TheKingOfChaos/Console-Server/3d/preview.png

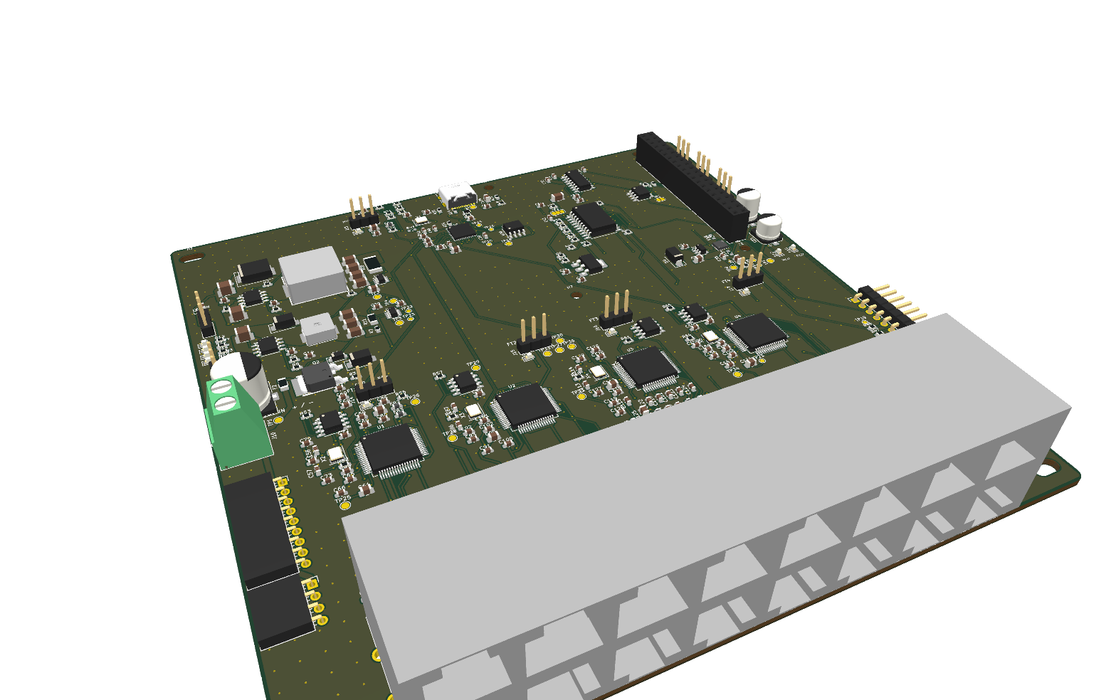
3d/preview.png
