TheKingOfChaos/Console-Server/bom/usb-console-server_bom.csv

Designator | Value | Footprint | LCSC | Spec | MPN | Note | Qty | DNP
C1,C4,C7,C13,C16,C20,C21,C24,C25,C30,C31,C32,C33,C34,C35,C37,C39,C41,C44,C45,C47,C48,C49,C50,C51,C52,C54,C59,C60,C64,C65,C66,C67,C68,C69,C70,C72,C74,C76,C77,C78,C79,C80,C81,C82,C83,C84,C85,C88,C89,C91,C92,C93,C94,C95,C96,C97,C99,C101,C103,C104,C105,C106,C107,C108,C109,C110,C111,C112,C115,C116,C118,C119,C120,C121,C122,C123,C124,C126,C128,C130,C131,C132,C133,C134,C135,C136,C137,C138,C139,C142,C143,C145,C146,C147,C148,C149,C150,C151,C153,C155,C157,C158,C159,C160,C161,C162,C163,C164,C165,C166 | 100nF | Capacitor_SMD:C_0603_1608Metric | C14663 | 50V X7R |  | VCAP to ANODE, >=25 V,VCCIO pin,VCORE pin,VREGIN | 111
C2,C3,C12 | 2.2uF | Capacitor_SMD:C_1210_3225Metric | C153036 | 100V X7R |  |  | 3
C5,C14,C36 | 4.7nF | Capacitor_SMD:C_0603_1608Metric | C53987 | 50V X7R |  |  | 3
C6,C15 | 47pF | Capacitor_SMD:C_0603_1608Metric | C1671 | 50V C0G |  |  | 2
C8,C9,C10,C11,C17,C18,C19,C55 | 22uF | Capacitor_SMD:C_1206_3216Metric | C77091 | 25V X5R |  |  | 8
C22,C174 | 1uF | Capacitor_SMD:C_0805_2012Metric | C91185 | 50V X7R |  |  | 2
C23,C26,C29,C71,C98,C125,C152 | 10uF | Capacitor_SMD:C_0805_2012Metric | C15850 | 25V X5R |  | local bulk | 7
C27 | 470uF | Capacitor_SMD:CP_Elec_6.3x7.7 | C335982 | 10V electrolytic 6.3x7.7 |  |  | 1
C28 | 220uF | Capacitor_SMD:CP_Elec_6.3x5.4 | C72494 | 10V electrolytic 6.3x5.4 |  |  | 1
C38,C40,C53,C73,C75,C100,C102,C127,C129,C154,C156 | 1uF | Capacitor_SMD:C_0603_1608Metric | C29936 | 25V X7R |  |  | 11
C42,C43,C61,C90,C117,C144 | 4.7uF | Capacitor_SMD:C_0805_2012Metric | C1779 | 25V X5R |  | VREGOUT: LDO compensation, min 3.3 uF | 6
C46 | 100uF | Capacitor_SMD:CP_Elec_10x10.5 | C51953411 | 63V electrolytic 10x10.5 |  |  | 1
C57,C58,C86,C87,C113,C114,C140,C141 | 33pF | Capacitor_SMD:C_0603_1608Metric | C1663 | 50V C0G |  | C0G | 8
C62,C63 | 15pF | Capacitor_SMD:C_0603_1608Metric | C1644 | 50V C0G |  | C0G, matched to 12 pF CL | 2
D1 | B560C | Diode_SMD:D_SMC | C85100 |  |  |  | 1
D2 | B360A | Diode_SMD:D_SMA | C94193 |  |  |  | 1
D3 | SMAJ26A | Diode_SMD:D_SMA | C148225 |  |  | 26 V standoff, 42.1 V max clamp | 1
D4 | BZT52C15 | Diode_SMD:D_SOD-123 | C668893 |  |  | 15 V gate clamp, cathode to source | 1
D5,D6,D7,D8,D10,D11,D12,D13,D14,D15,D16 | green | LED_SMD:LED_0603_1608Metric | C965805 |  |  | +24V present,+3.3V present,+3V3_MCU present,+5V present,Pi 5 V present,cluster powered,heartbeat = healthy; solid or dark = hung,hub section powered | 11
D9 | SMAJ6.0A | Diode_SMD:D_SMA | C223993 |  |  |  | 1
F2 | 0468002.NRHF | Fuse:Fuse_1206_3216Metric | C187611 |  |  | 2 A time-lag 63 V DC, I2t 0.506 A2s | 1
FB1,FB2,FB3,FB4,FB5,FB6,FB7,FB8,FB9 | BLM18KG601SN1D | Inductor_SMD:L_0603_1608Metric | C85833 |  |  |  | 9
J1 | USB-C | Connector_USB:USB_C_Receptacle_HRO_TYPE-C-31-M-12 | C165948 |  |  |  | 1
J2 | RPi GPIO 2x20 | Connector_PinSocket_2.54mm:PinSocket_2x20_P2.54mm_Vertical | C2977589 |  |  |  | 1
J3 | PWR_CHAIN | Connector_PinHeader_2.54mm:PinHeader_1x04_P2.54mm_Horizontal | C492412 |  |  | 1x04 R/A pin header | 1
J4 | PWR_CHAIN | Connector_PinSocket_2.54mm:PinSocket_1x04_P2.54mm_Horizontal | C2897386 |  |  | 1x04 R/A socket | 1
J5 | HC-RJ45-059D-2x8-2-04 | console_server:RJ45_HC-RJ45-059D-2x8 | C46261623 |  |  |  | 1
J6 | PI_CONSOLE | Connector_PinHeader_2.54mm:PinHeader_1x03_P2.54mm_Vertical | C49257 |  |  |  | 1
J7 | UPDI | Connector_PinHeader_2.54mm:PinHeader_1x03_P2.54mm_Vertical | C49257 |  |  |  | 1
J8 | LINK | Connector_PinHeader_2.54mm:PinHeader_1x09_P2.54mm_Horizontal | C492417 |  |  |  | 1
J9 | LINK | Connector_PinSocket_2.54mm:PinSocket_1x09_P2.54mm_Horizontal | C2897391 |  |  |  | 1
J10 | 24V IN | TerminalBlock_Phoenix:TerminalBlock_Phoenix_MKDS-1,5-2-5.08_1x02_P5.08mm_Horizontal | C8465 |  |  | 5.08 mm screw terminal, 18 A; same node as the chain connectors | 1
J11 | BUCK5_IN | Connector_PinHeader_2.54mm:PinHeader_1x03_P2.54mm_Vertical | C49257 |  |  | bring-up jumper, 1.2 A max | 1
J12 | BUCK3_IN | Connector_PinHeader_2.54mm:PinHeader_1x03_P2.54mm_Vertical | C49257 |  |  | bring-up jumper, 1.2 A max | 1
J13 | HUB_3V3 | Connector_PinHeader_2.54mm:PinHeader_1x03_P2.54mm_Vertical | C49257 |  |  | bring-up jumper | 1
J14,J15,J16,J17 | FT_3V3 | Connector_PinHeader_2.54mm:PinHeader_1x03_P2.54mm_Vertical | C49257 |  |  | bring-up jumper | 4
J19 | MCU_UART | Connector_PinHeader_2.54mm:PinHeader_1x03_P2.54mm_Vertical | C49257 |  |  |  | 1
L1 | 10uH | console_server:L_Bourns_SRP1265A | C305223 |  | TMPC1265HP-100MG-D | Isat 15.5 A, Irms 10 A (SRP1265A-100M equivalent) | 1
L2 | 10uH | Inductor_SMD:L_Bourns_SRP7028A_7.3x6.6mm | C2687402 |  | SRP7028A-100M | Isat 6 A, Irms 3.5 A | 1
Q1 | AON7524 | console_server:DFN-8_L3.0-W3.0-P0.65-BL-2 | C431195 |  |  |  | 1
Q2 | IRFR5305TRPBF | console_server:TO-252-3_L6.5-W6.1-P4.58-LS9.9-BR | C2624 |  |  | P-ch 55 V 65 mOhm; drain to input | 1
R1,R5 | 243k | Resistor_SMD:R_0603_1608Metric | C403098 | 1% 0603 |  |  | 2
R2,R6 | 16.9k | Resistor_SMD:R_0603_1608Metric | C2933158 | 1% 0603 |  |  | 2
R3 | 53.6k | Resistor_SMD:R_0603_1608Metric | C2930115 | 1% 0603 |  |  | 1
R4,R8,R22,R28,R29,R30,R31,R32,R33,R34,R41,R44,R46,R48,R54,R58,R62,R66 | 10k | Resistor_SMD:R_0603_1608Metric | C25804 | 1% 0603 |  | SCL pull-up AND CFG_SEL0 strap,one pull-up for all four FT4232H | 18
R7 | 31.6k | Resistor_SMD:R_0603_1608Metric | C25967 | 1% 0603 |  |  | 1
R9 | 240 | Resistor_SMD:R_0603_1608Metric | C114613 | 1% 0603 |  | 1.25V/240R = 5.2 mA min load; do not raise | 1
R10 | 5m | Resistor_SMD:R_2512_6332Metric | C393074 | 5 mOhm 1% 3W 2512 shunt |  | +5V shunt | 1
R11 | 10m | Resistor_SMD:R_1206_3216Metric | C188070 | 10 mOhm 1% 1W 1206 shunt |  | +3.3V shunt | 1
R12 | 22k | Resistor_SMD:R_0603_1608Metric | C31850 | 1% 0603 |  |  | 1
R13,R19,R53,R57,R61,R65 | 2.2k | Resistor_SMD:R_0603_1608Metric | C4190 | 1% 0603 |  |  | 6
R14,R15,R36,R55,R59,R63,R67 | 470 | Resistor_SMD:R_0603_1608Metric | C23179 | 1% 0603 |  |  | 7
R16 | 390 | Resistor_SMD:R_0603_1608Metric | C23151 | 1% 0603 |  |  | 1
R20,R21 | 3.9k | Resistor_SMD:R_0603_1608Metric | C23018 | 1% 0603 |  |  | 2
R23,R24 | 5.1k | Resistor_SMD:R_0603_1608Metric | C23186 | 1% 0603 |  |  | 2
R25,R37 | 47k | Resistor_SMD:R_0603_1608Metric | C111134 | 1% 0603 |  |  | 2
R26,R47 | 100k | Resistor_SMD:R_0603_1608Metric | C25803 | 1% 0603 |  |  | 2
R27 | 1M | Resistor_SMD:R_0603_1608Metric | C22935 | 1% 0603 |  |  | 1
R35,R52,R56,R60,R64 | 12k | Resistor_SMD:R_0603_1608Metric | C22790 | 1% |  |  | 5
R38 | 4.3k | Resistor_SMD:R_0603_1608Metric | C23159 | 1% 0603 |  |  | 1
R39,R40 | 4.7k | Resistor_SMD:R_0603_1608Metric | C23162 | 1% 0603 |  |  | 2
R42,R45,R50 | 0 | Resistor_SMD:R_0603_1608Metric | C21189 | jumper |  | ID strap: fit on boards 1, 2,ID strap: fit on boards 1, 3 | 3
R49 | 1k | Resistor_SMD:R_0603_1608Metric | C22548 | 1% 0603 |  |  | 1
U1,U2,U3,U4 | FT4232HL | Package_QFP:LQFP-64_10x10mm_P0.5mm | C56742 |  |  |  | 4
U5 | USB2514BI-AEZG-TR | Package_DFN_QFN:QFN-36-1EP_6x6mm_P0.5mm_EP3.7x3.7mm | C58940 |  |  |  | 1
U6 | ATtiny3216-SF | Package_SO:SOIC-20W_7.5x12.8mm_P1.27mm | C1340355 |  |  |  | 1
U7 | LM317 | Package_TO_SOT_SMD:SOT-223-3_TabPin2 | C5296732 |  |  |  | 1
U8 | TPS54560BDDAR | Package_SO:Texas_HSOP-8-1EP_3.9x4.9mm_P1.27mm_ThermalVias | C1850354 |  |  |  | 1
U9 | TPS54360BDDAR | Package_SO:TI_SO-PowerPAD-8_ThermalVias | C524806 |  |  |  | 1
U10,U11,U12,U13,U14,U15,U16,U17 | MAX3232EIDR | Package_SO:SOIC-16_3.9x9.9mm_P1.27mm | C193666 |  |  |  | 8
U18 | SP3232EEN-L/TR | Package_SO:SOIC-16_3.9x9.9mm_P1.27mm | C9378 |  |  |  | 1
U19 | LM74700QDBVRQ1 | Package_TO_SOT_SMD:SOT-23-6 | C2941042 |  |  |  | 1
U20 | 24LC02B-I/SN | Package_SO:SOIC-8_3.9x4.9mm_P1.27mm | C1348870 |  |  |  | 1
U21 | 24LC32A-I/SN | Package_SO:SOIC-8_3.9x4.9mm_P1.27mm | C511262 |  |  |  | 1
U22 | PRTR5V0U2F | console_server:SOT886_L1.5-W1.0-P0.50-LS1.00-BL | C478118 |  |  |  | 1
U23,U24 | INA219AIDCNR | Package_TO_SOT_SMD:SOT-23-8 | C87469 |  |  |  | 2
U31,U32,U33,U34 | 93LC46BT-I/SN | Package_SO:SOIC-8_3.9x4.9mm_P1.27mm | C16253 |  |  |  | 4
X1 | 24MHz | Crystal:Crystal_SMD_3225-4Pin_3.2x2.5mm | C5444545 |  |  | XL2EL89COI-111YLC-24M, CL 12 pF | 1
X2,X3,X4,X5 | 12MHz | Crystal:Crystal_SMD_3225-4Pin_3.2x2.5mm | C9002 |  |  | X322512MSB4SI, CL 20 pF | 4
