TheKingOfChaos/Console-Server/jlcpcb/usb-console-server_full_loose_parts.csv

LCSC Part Number | Qty per board | Value | Footprint | Designators
C100114 | 7 | 2.54 mm jumper cap | - | one per bring-up header J11-J17
