TheKingOfChaos/Console-Server/jlcpcb/usb-console-server_lcsc_order_3boards_through_hole_only.csv

LCSC Part Number | Quantity | Manufacturer Part | Value | Package | Designators
C49257 | 30 |  | PI_CONSOLE | PinHeader_1x03_P2.54mm_Vertical | J6,J7,J11,J12,J13,J14,J15,J16,J17,J19
C100114 | 21 |  | 2.54 mm jumper cap | - | one per bring-up header J11-J17
C492412 | 3 |  | PWR_CHAIN | PinHeader_1x04_P2.54mm_Horizontal | J3
C2897386 | 3 |  | PWR_CHAIN | PinSocket_1x04_P2.54mm_Horizontal | J4
C46261623 | 3 |  | HC-RJ45-059D-2x8-2-04 | RJ45_HC-RJ45-059D-2x8 | J5
C492417 | 3 |  | LINK | PinHeader_1x09_P2.54mm_Horizontal | J8
C2897391 | 3 |  | LINK | PinSocket_1x09_P2.54mm_Horizontal | J9
C8465 | 3 |  | 24V IN | TerminalBlock_Phoenix_MKDS-1,5-2-5.08_1x02_P5.08mm_Horizontal | J10
C2977589 | 1 |  | RPi GPIO 2x20 | PinSocket_2x20_P2.54mm_Vertical | J2
