TheKingOfChaos/Console-Server/3d/usb-console-server.step

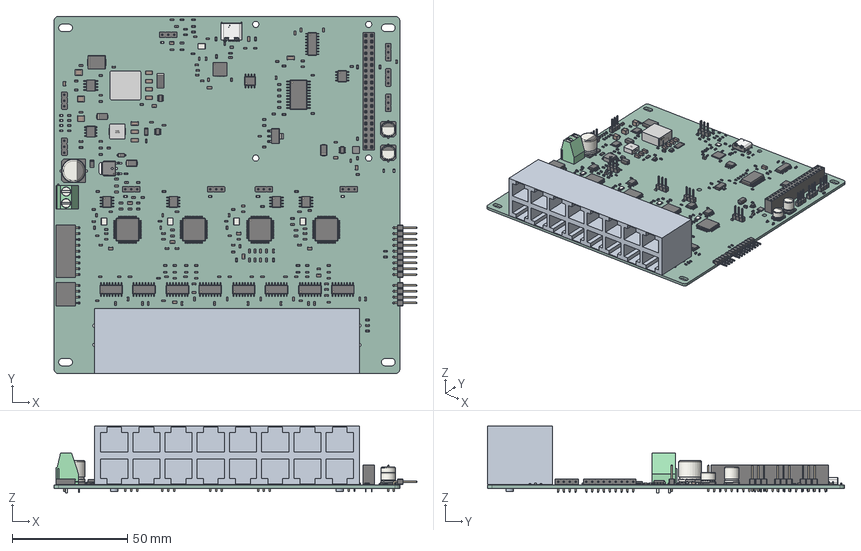
[picture p2: CAD file, 2026-10-31]
3d/usb-console-server.step
157.4 x 155.0 x 28.9 mm
LED_0603_1608Metric x 11
Crystal_SMD_3225-4Pin_3.2x2.5mm x 5
R_0603_1608Metric x 65
PinHeader_1x03_P254mm_Vertical x 10
C_0603_1608Metric x 138
C_0805_2012Metric x 15
L_0603_1608Metric x 9
PinHeader_1x09_P254mm_Horizontal
SOT-223
C_1206_3216Metric x 8
CP_Elec_63x54
SOIC-16_3.9x9.9mm_P1.27mm x 9
USB-C_SMD-TYPE-C-31-M-12
Fuse_1206_3216Metric
PinSocket_2x20_P2.54mm_Vertical
PinSocket_1x09_P2.54mm_Horizontal
SOIC-8_3.9x4.9mm_P1.27mm x 6
PinHeader_1x04_P254mm_Horizontal
D_SMA x 3
HSOP-8-1EP_3.9x4.9mm_P1.27mm_EP2.41x3.1mm
D_SOD-123
R_1206_3216Metric
SOT-23-8 x 2
QFN-36-1EP_6x6mm_Pitch0.5mm
C_1210_3225Metric x 3
TI_SO-PowerPAD-8
IND-SMD_L13.5-W12.5
LQFP-64_10x10mm_P0.5mm x 4
PinSocket_1x04_P2.54mm_Horizontal
R_2512_6332Metric
D_SMC
SOT-23-6
IND-SMD_L7.1-W6.6-H2.8
CP_Elec_10x105
CP_Elec_63x77
SOT886_L1.5-W1.0-H0.5-P0.50-LS1.00-BL
TO-252-3_L6.5-W6.1-P4.58-LS9.9-BR
TerminalBlock_Phoenix_MKDS-1,5-2-5.08_1x02_P5.08mm_Horizontal
SOIC-20W_7.5x12.8mm_P1.27mm
DFN-8_L3.0-W3.0-P0.65-BL-2
usb-console-server_PCB
