TheKingOfChaos/Console-Server/usb-console-server.kicad_pcb

## KiCad design usb-console-server.kicad_pcb (2026-11-04)

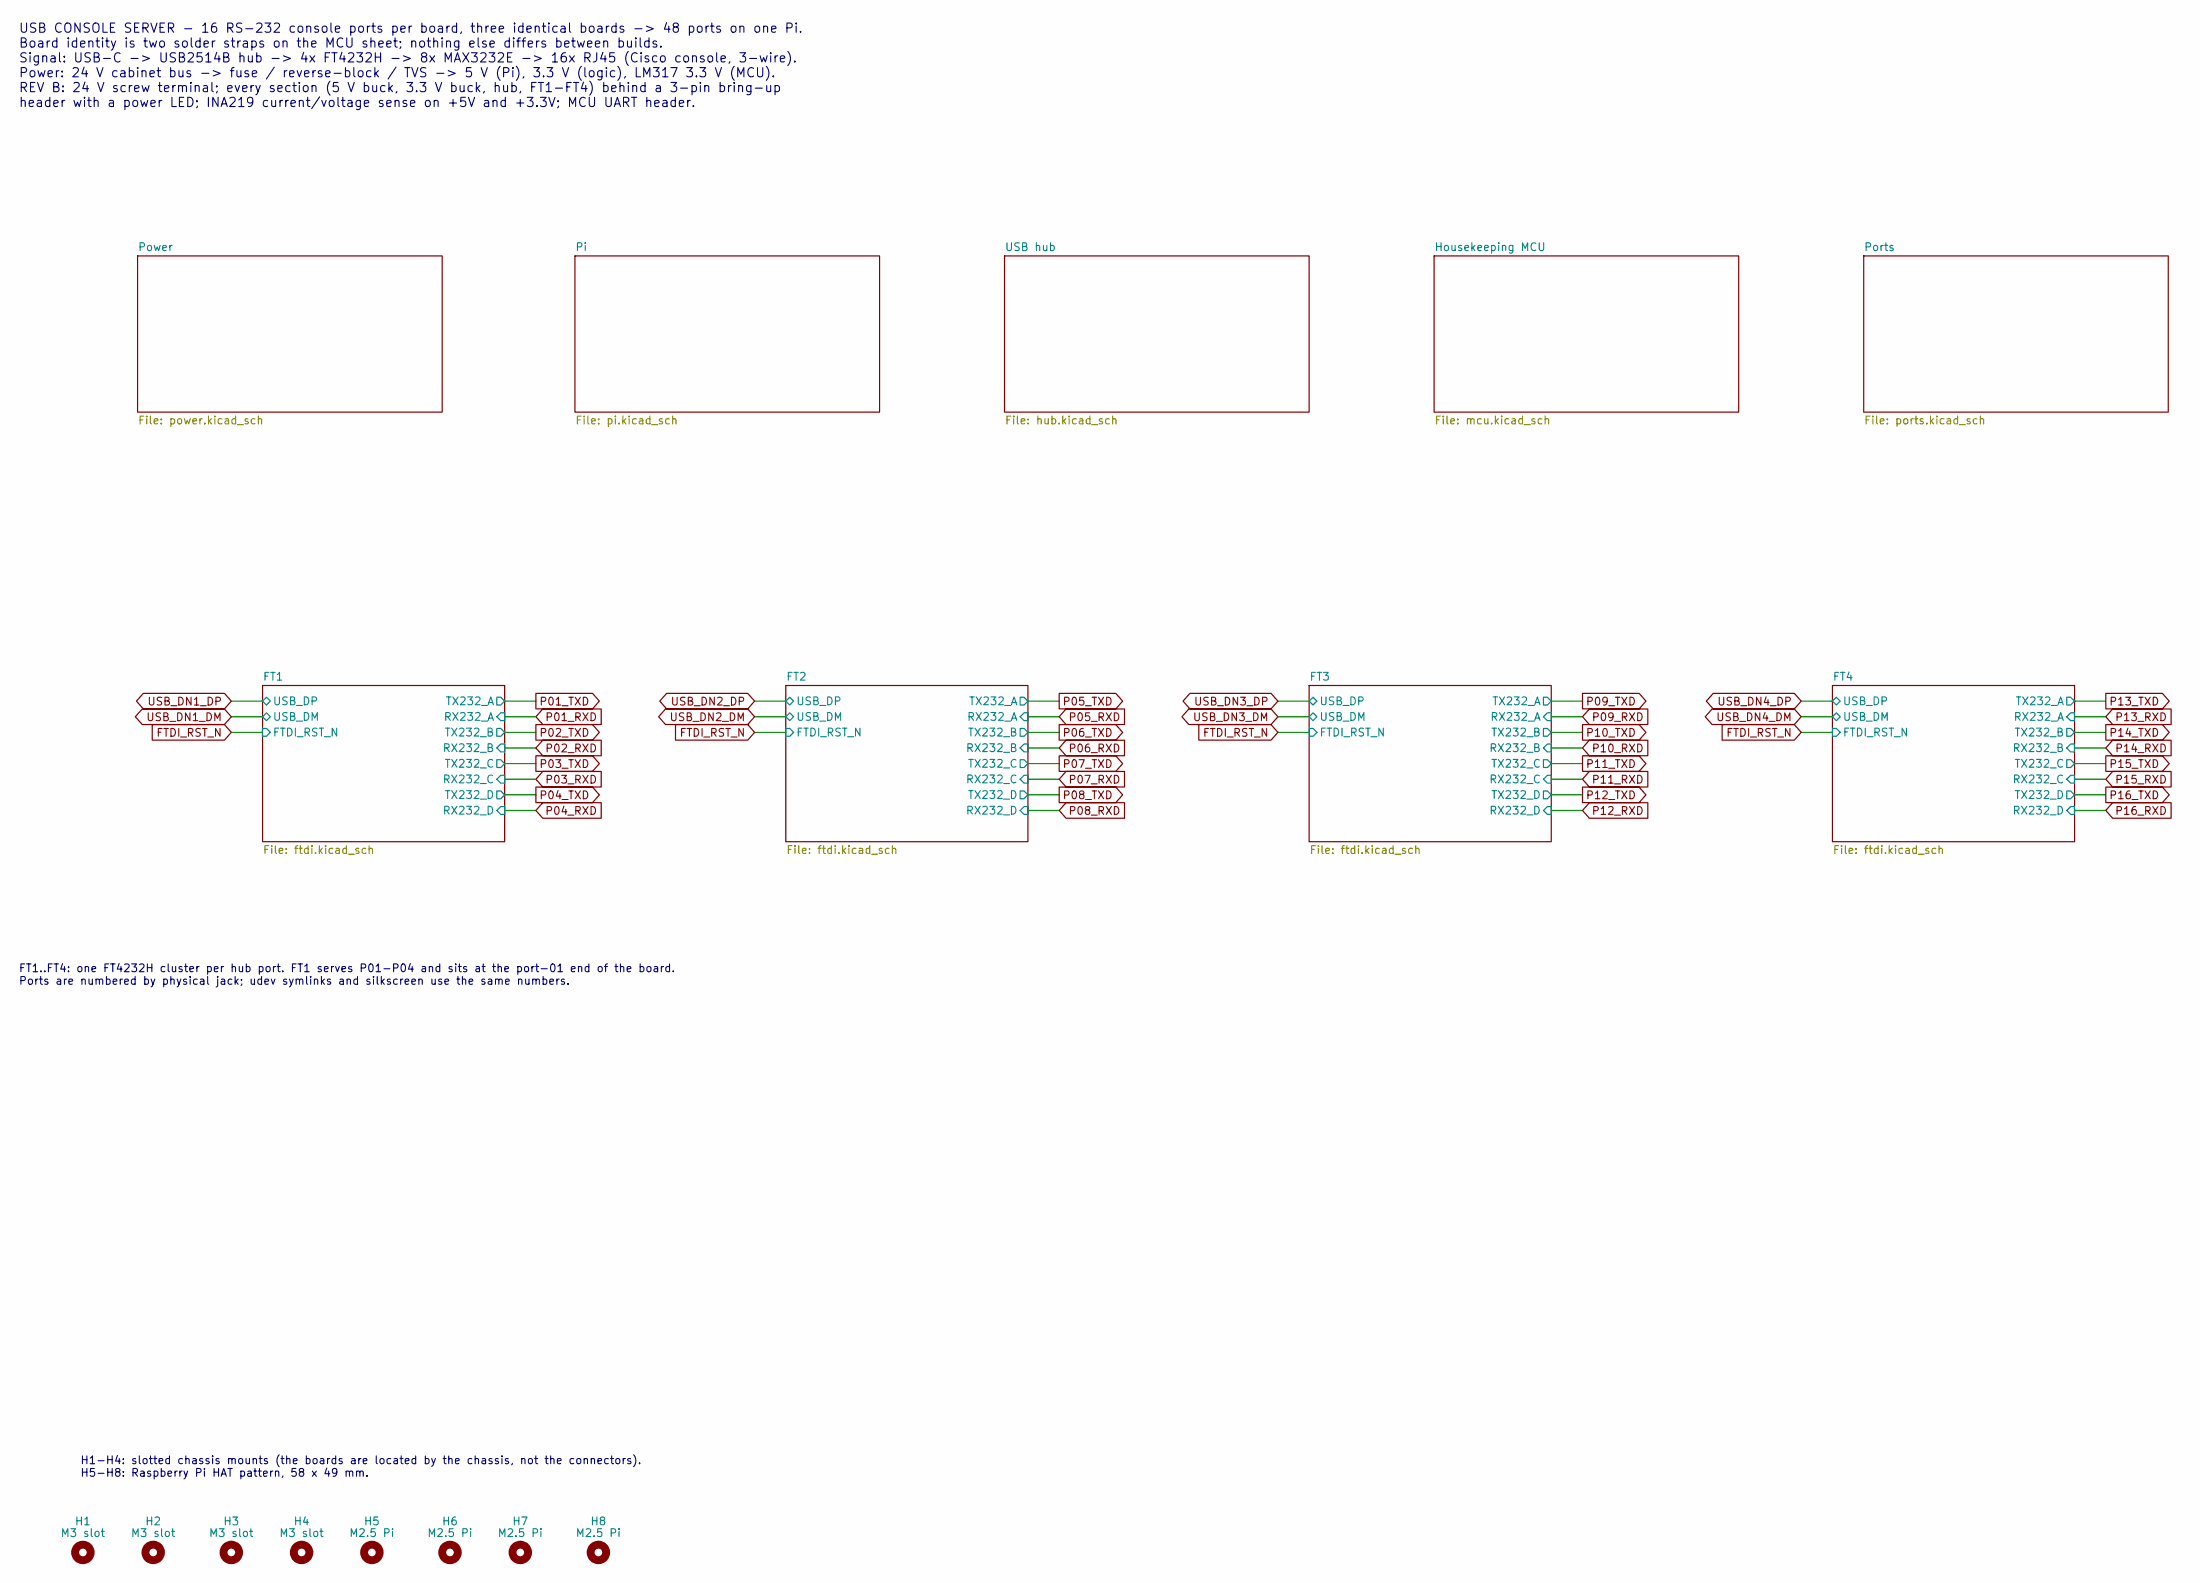
[picture p3: schematic usb-console-server.kicad_sch, USB Console Server - top level]

Parts:
H1, H2, H3, H4: M3 slot; MountingSlot_3.2x6mm
H5, H6, H7, H8: M2.5 Pi; MountingHole_2.7mm_M2.5

Notes on the sheet:
USB CONSOLE SERVER - 16 RS-232 console ports per board, three identical boards -> 48 ports on one Pi. Board identity is two solder straps on the MCU sheet; nothing else differs between builds. Signal: USB-C -> USB2514B hub -> 4x FT4232H -> 8x MAX3232E -> 16x RJ45 (Cisco console, 3-wire). Power: 24 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
FT1..FT4: one FT4232H cluster per hub port. FT1 serves P01-P04 and sits at the port-01 end of the board. Ports are numbered by physical jack; udev symlinks and silkscreen use the same numbers.
H1-H4: slotted chassis mounts (the boards are located by the chassis, not the connectors). H5-H8: Raspberry Pi HAT pattern, 58 x 49 mm.

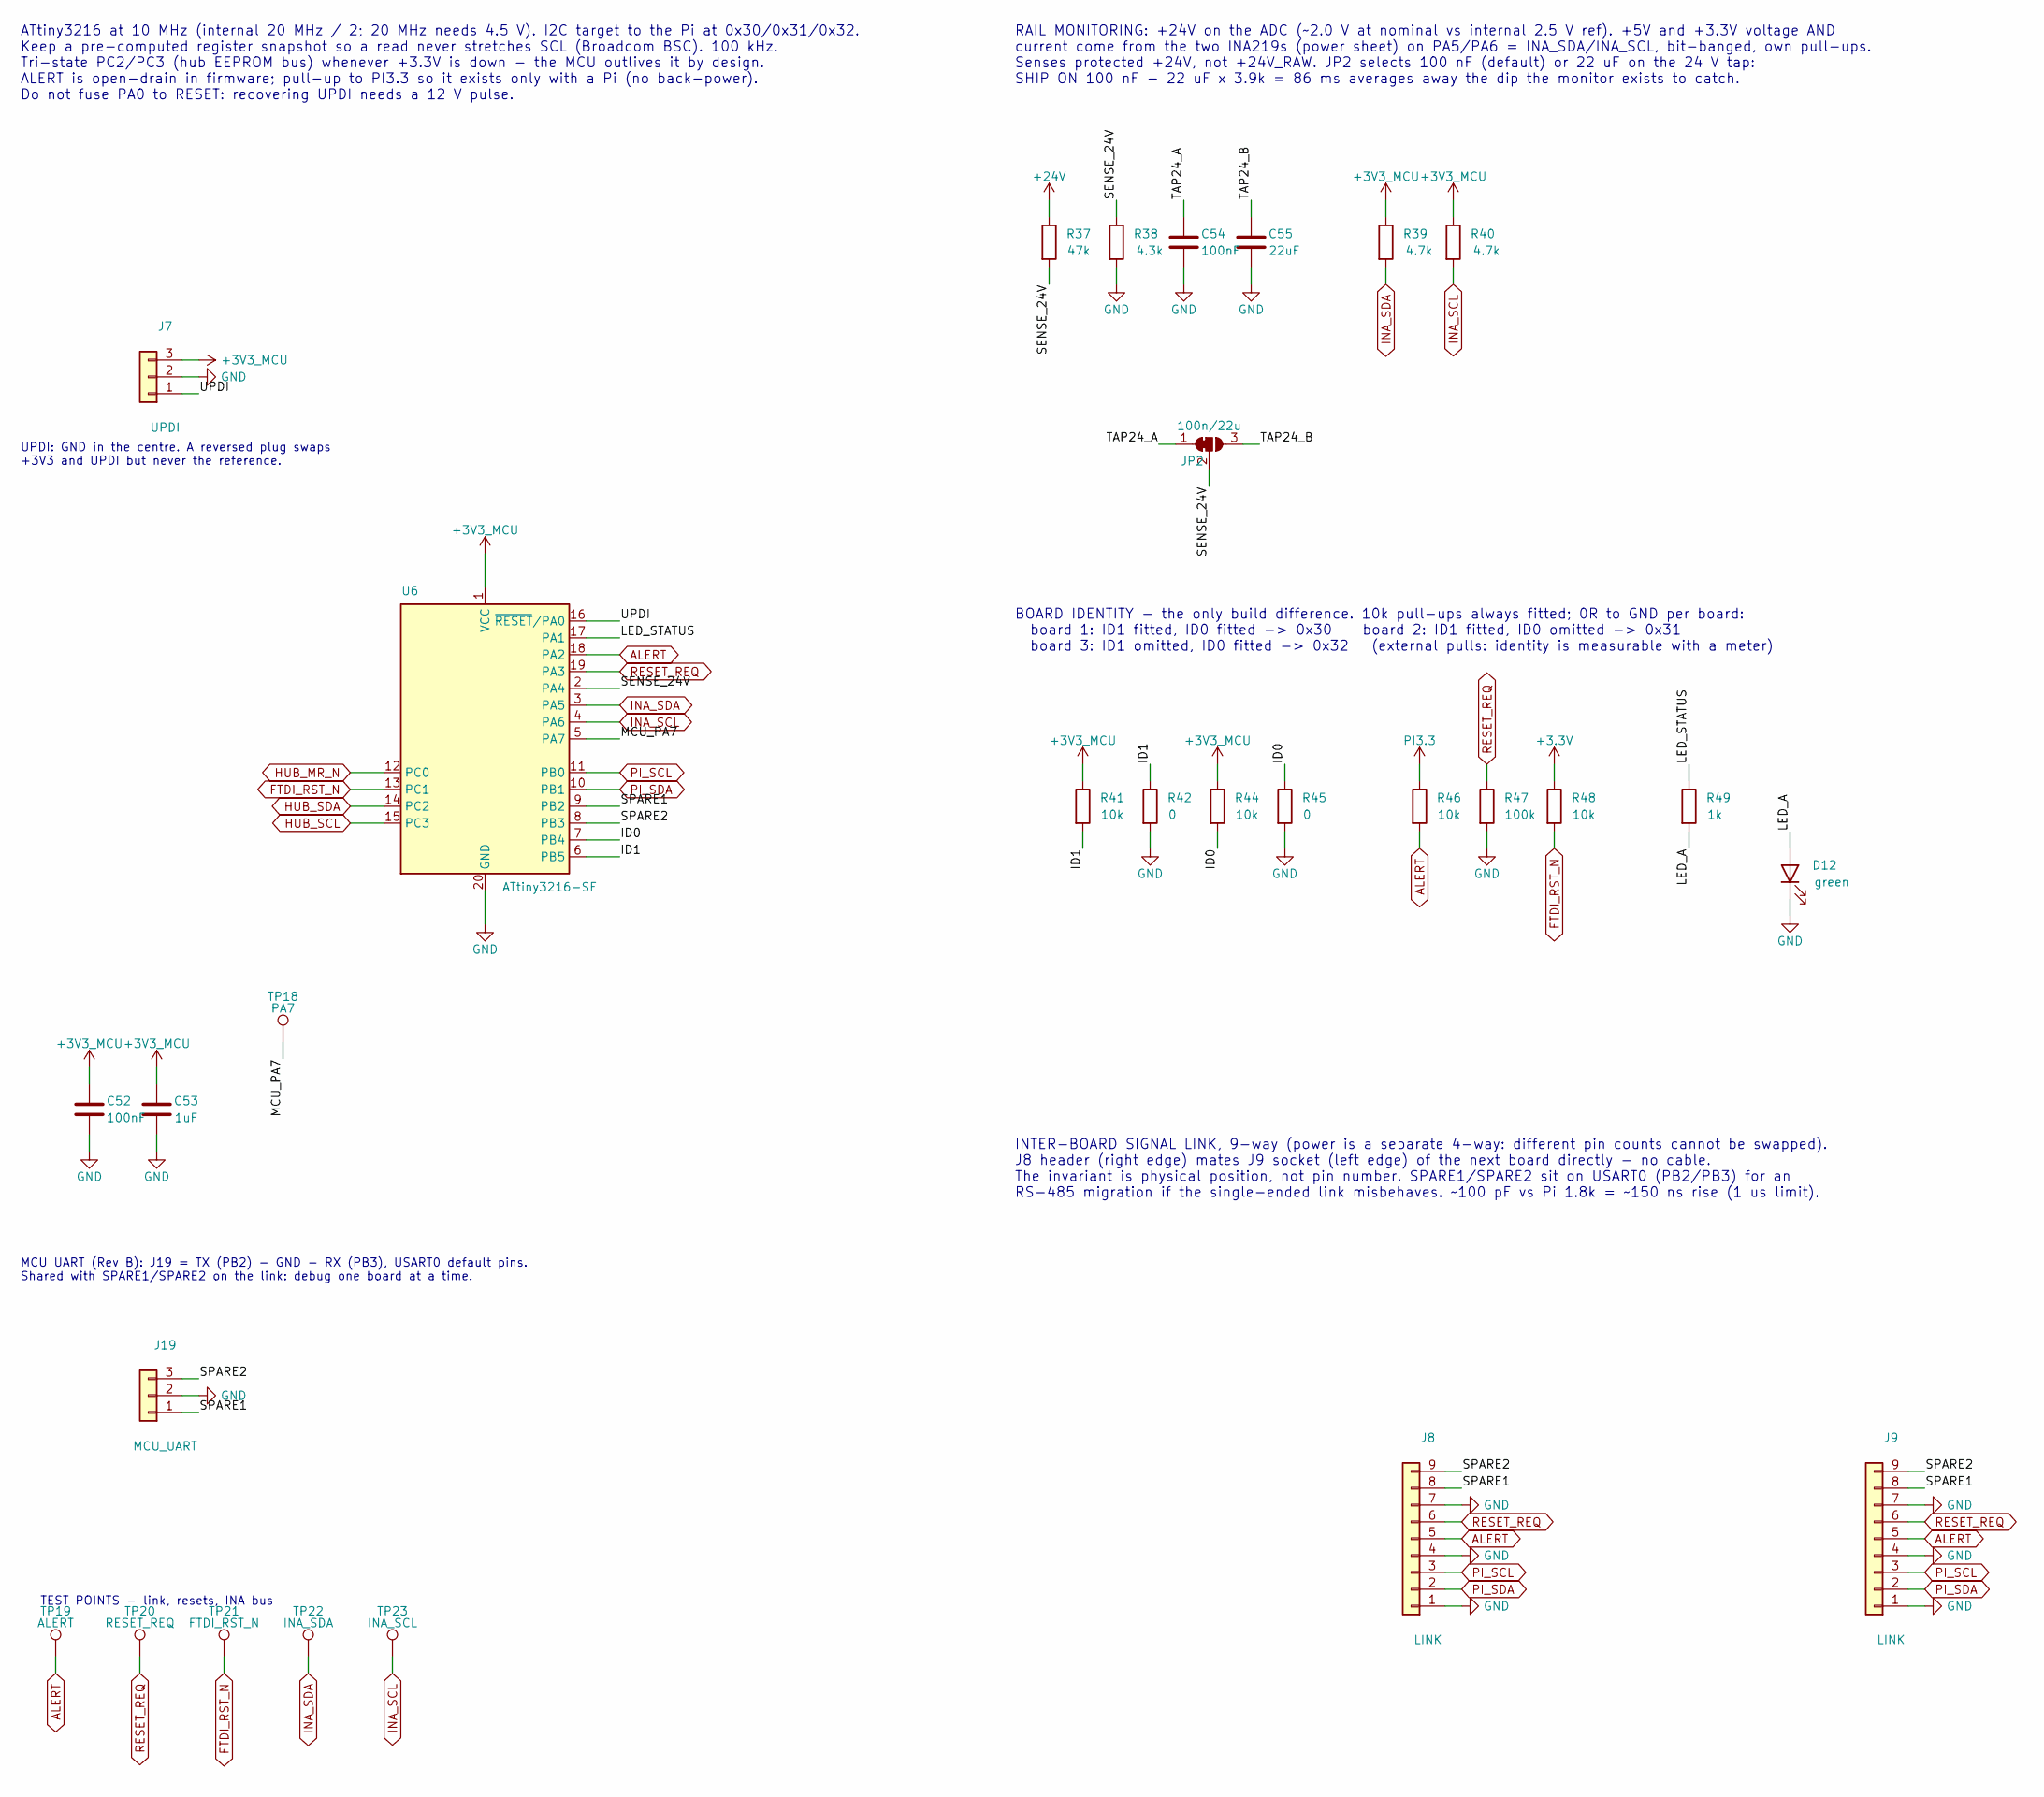
[picture p4: schematic mcu.kicad_sch, Housekeeping MCU and inter-board link]

Parts:
C52, C54: 100nF; C_0603_1608Metric; LCSC C14663
C53: 1uF; C_0603_1608Metric; LCSC C29936
C55: 22uF; C_1206_3216Metric; LCSC C77091
D12: green; LED_0603_1608Metric; LCSC C965805
J7: UPDI; PinHeader_1x03_P2.54mm_Vertical; LCSC C49257
J8: LINK; PinHeader_1x09_P2.54mm_Horizontal; LCSC C492417
J9: LINK; PinSocket_1x09_P2.54mm_Horizontal; LCSC C2897391
J19: MCU_UART; PinHeader_1x03_P2.54mm_Vertical; LCSC C49257
JP2: 100n/22u; SolderJumper-3_P1.3mm_Bridged12_RoundedPad1.0x1.5mm
R37: 47k; R_0603_1608Metric; LCSC C111134
R38: 4.3k; R_0603_1608Metric; LCSC C23159
R39, R40: 4.7k; R_0603_1608Metric; LCSC C23162
R41, R44, R46, R48: 10k; R_0603_1608Metric; LCSC C25804
R42, R45: 0; R_0603_1608Metric; LCSC C21189
R47: 100k; R_0603_1608Metric; LCSC C25803
R49: 1k; R_0603_1608Metric; LCSC C22548
TP18: PA7; TestPoint_Pad_D1.5mm
TP19: ALERT; TestPoint_Pad_D1.0mm
TP20: RESET_REQ; TestPoint_Pad_D1.0mm
TP21: FTDI_RST_N; TestPoint_Pad_D1.0mm
TP22: INA_SDA; TestPoint_Pad_D1.0mm
TP23: INA_SCL; TestPoint_Pad_D1.0mm
U6: ATtiny3216-SF; SOIC-20W_7.5x12.8mm_P1.27mm; LCSC C1340355

Connections:
+3.3V: R48.1; also elsewhere on the board
+3V3_MCU: C52.1, C53.1, J7.3, R39.1, R40.1, R41.1, R44.1, U6.1 (VCC); also elsewhere on the board
+24V: R37.1; also elsewhere on the board
/Housekeeping MCU/ID0: R44.2, R45.1, U6.7 (PB4)
/Housekeeping MCU/ID1: R41.2, R42.1, U6.6 (PB5)
/Housekeeping MCU/LED_A: D12.2 (A), R49.2
/Housekeeping MCU/LED_STATUS: R49.1, U6.17 (PA1)
/Housekeeping MCU/MCU_PA7: TP18.1, U6.5 (PA7)
/Housekeeping MCU/SENSE_24V: JP2.2 (C), R37.2, R38.1, U6.2 (PA4)
/Housekeeping MCU/SPARE1: J8.8, J9.8, J19.1, U6.9 (PB2)
/Housekeeping MCU/SPARE2: J8.9, J9.9, J19.3, U6.8 (PB3)
/Housekeeping MCU/TAP24_A: C54.1, JP2.1 (A)
/Housekeeping MCU/TAP24_B: C55.1, JP2.3 (B)
/Housekeeping MCU/UPDI: J7.1, U6.16 (~RESET/PA0)
ALERT: J8.5, J9.5, R46.2, TP19.1, U6.18 (PA2); also elsewhere on the board
FTDI_RST_N: R48.2, TP21.1, U6.13 (PC1); also elsewhere on the board
GND: C52.2, C53.2, C54.2, C55.2, D12.1 (K), J7.2, J8.1, J8.4, J8.7, J9.1, J9.4, J9.7, J19.2, R38.2, R42.2, R45.2, R47.2, U6.20 (GND); also elsewhere on the board
HUB_MR_N: U6.12 (PC0); also elsewhere on the board
HUB_SCL: U6.15 (PC3); also elsewhere on the board
HUB_SDA: U6.14 (PC2); also elsewhere on the board
INA_SCL: R40.2, TP23.1, U6.4 (PA6); also elsewhere on the board
INA_SDA: R39.2, TP22.1, U6.3 (PA5); also elsewhere on the board
PI3.3: R46.1; also elsewhere on the board
PI_SCL: J8.3, J9.3, U6.11 (PB0); also elsewhere on the board
PI_SDA: J8.2, J9.2, U6.10 (PB1); also elsewhere on the board
RESET_REQ: J8.6, J9.6, R47.1, TP20.1, U6.19 (PA3); also elsewhere on the board

Notes on the sheet:
ATtiny3216 at 10 MHz (internal 20 MHz / 2; 20 MHz needs 4.5 V). I2C target to the Pi at 0x30/0x31/0x32. Keep a pre-computed register snapshot so a read never stretches SCL (Broadcom BSC). 100 kHz. Tri-state PC2/PC3 (hub EEPROM bus) whenever +3.3V is down - the MCU outlives it by design. ALERT is op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
INTER-BOARD SIGNAL LINK, 9-way (power is a separate 4-way: different pin counts cannot be swapped). J8 header (right edge) mates J9 socket (left edge) of the next board directly - no cable. The invariant is physical position, not pin number. SPARE1/SPARE2 sit on USART0 (PB2/PB3) for an RS-485 migra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
MCU UART (Rev B): J19 = TX (PB2) - GND - RX (PB3), USART0 default pins. Shared with SPARE1/SPARE2 on the link: debug one board at a time.
BOARD IDENTITY - the only build difference. 10k pull-ups always fitted; 0R to GND per board: board 1: ID1 fitted, ID0 fitted -> 0x30 board 2: ID1 fitted, ID0 omitted -> 0x31 board 3: ID1 omitted, ID0 fitted -> 0x32 (external pulls: identity is measurable with a meter)
TEST POINTS - link, resets, INA bus
UPDI: GND in the centre. A reversed plug swaps +3V3 and UPDI but never the reference.
RAIL MONITORING: +24V on the ADC (~2.0 V at nominal vs internal 2.5 V ref). +5V and +3.3V voltage AND current come from the two INA219s (power sheet) on PA5/PA6 = INA_SDA/INA_SCL, bit-banged, own pull-ups. Senses protected +24V, not +24V_RAW. JP2 selects 100 nF (default) or 22 uF on the 24 V tap: S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

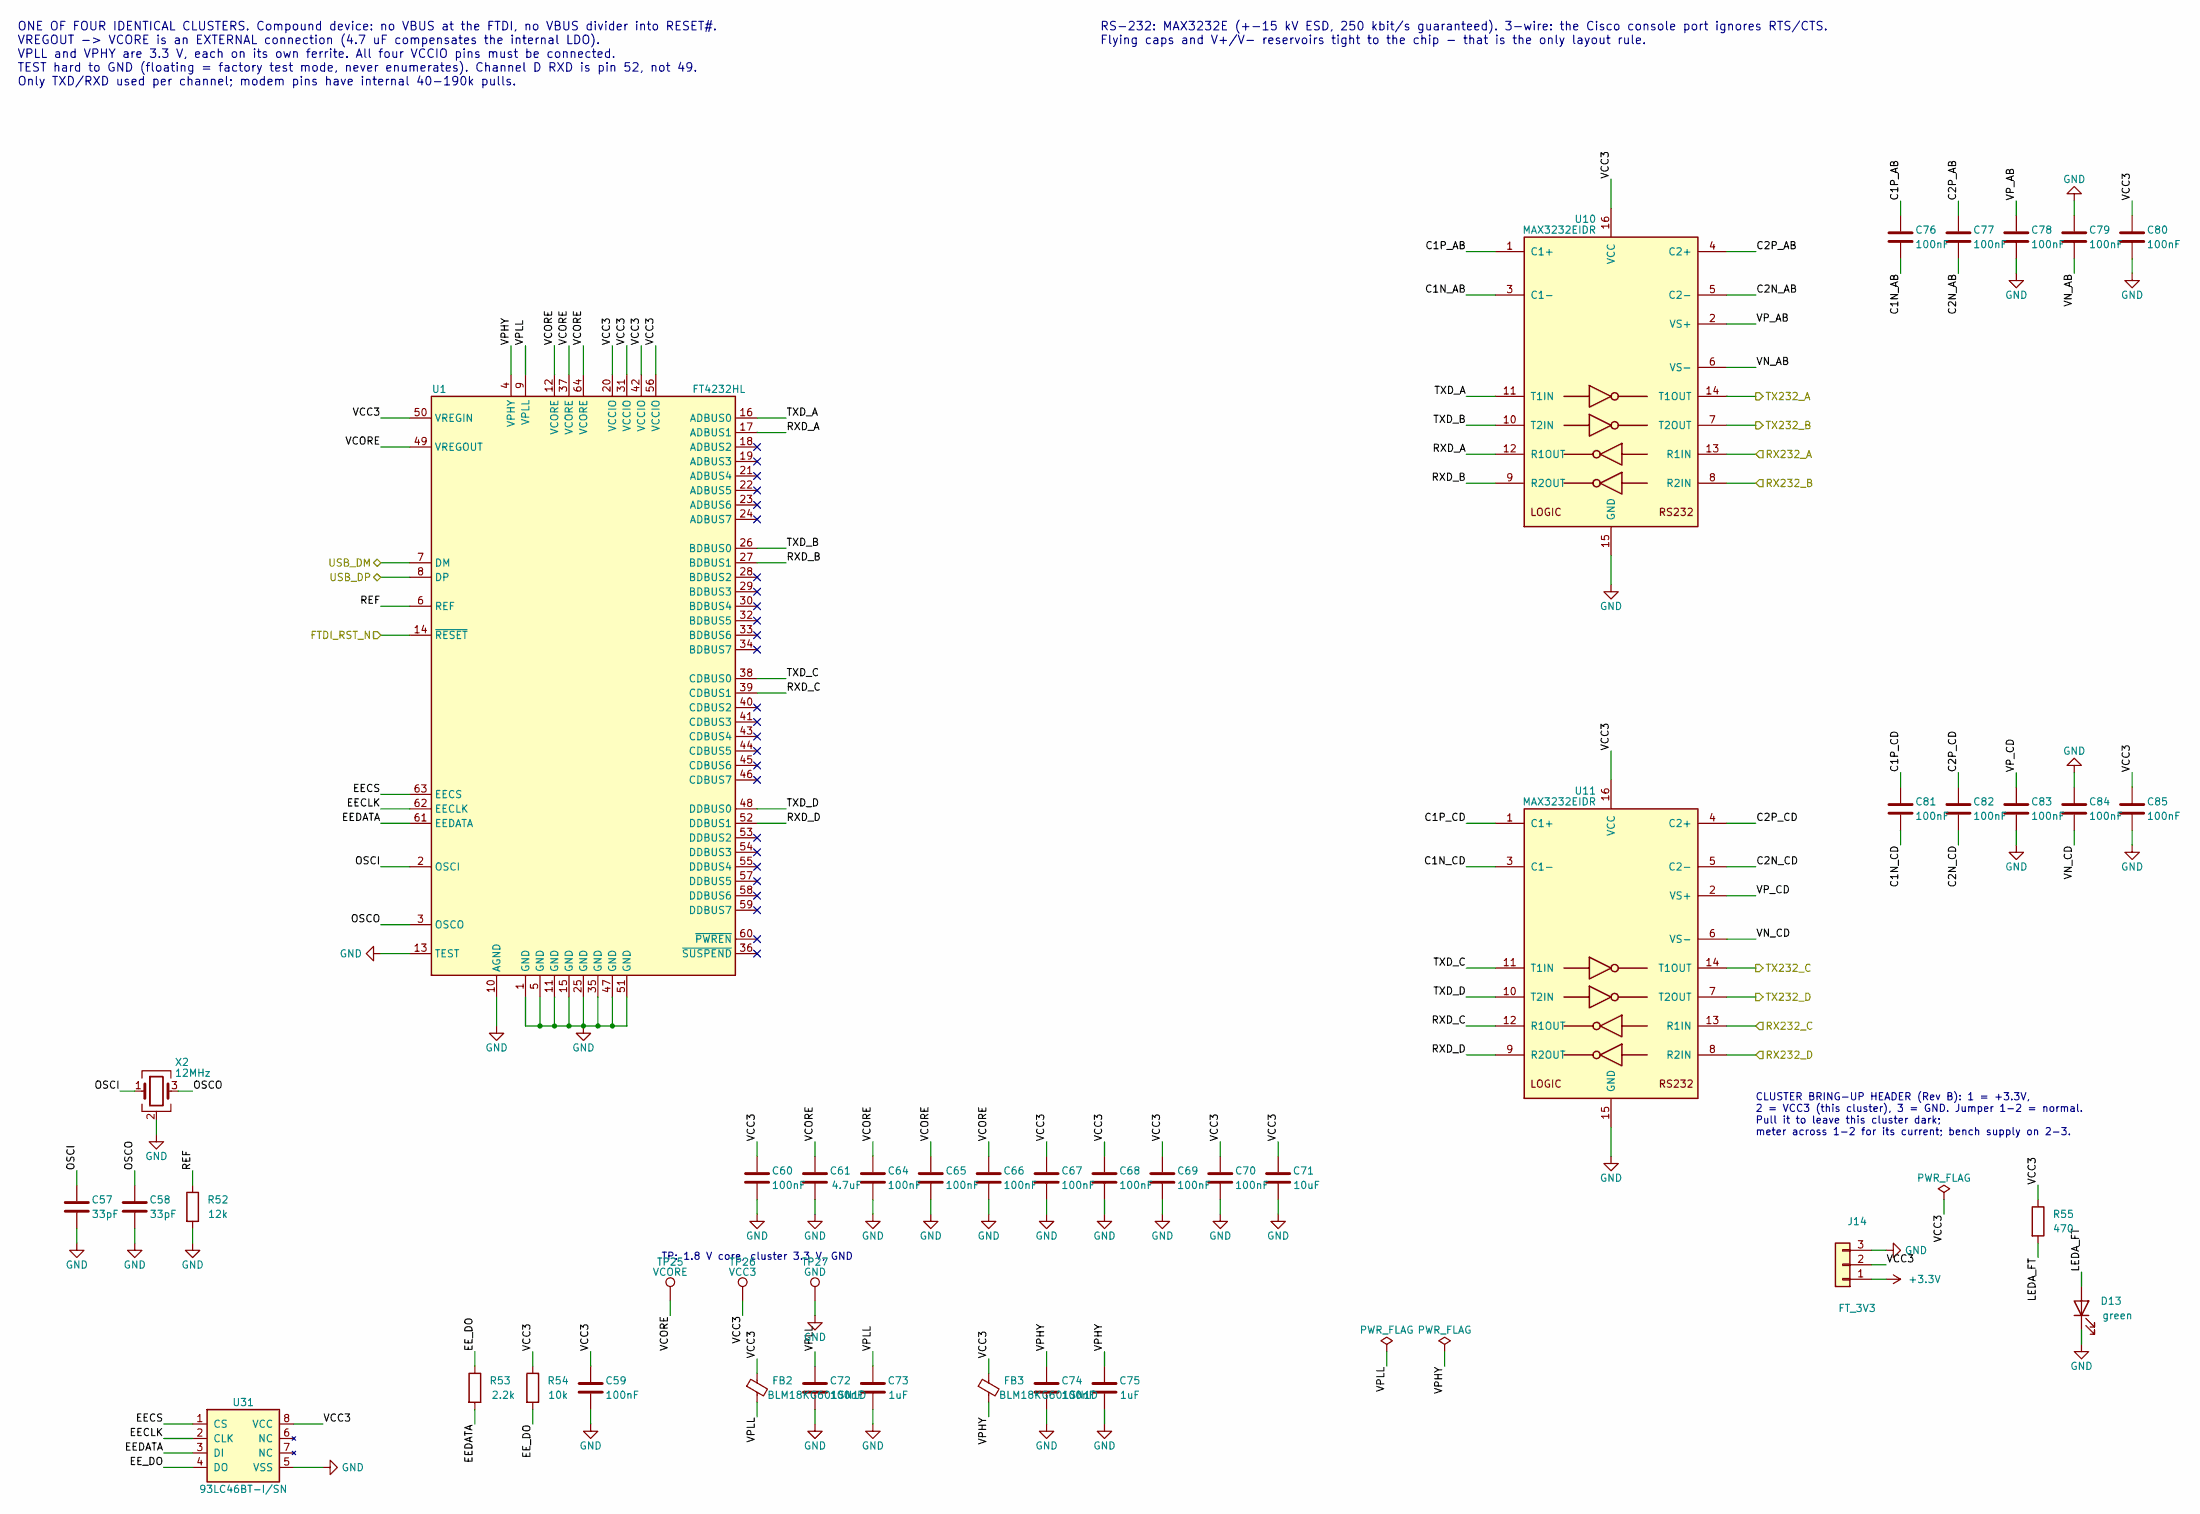
[picture p5: schematic ftdi.kicad_sch, FT4232H cluster (x4): 4 UART channels -> 4 RS-232 ports]

Parts:
C57, C58: 33pF; C_0603_1608Metric; LCSC C1663
C59, C60, C64, C65, C66, C67, C68, C69, C70, C72, C74, C76, C77, C78, C79, C80, C81, C82, C83, C84, C85: 100nF; C_0603_1608Metric; LCSC C14663
C61: 4.7uF; C_0805_2012Metric; LCSC C1779
C71: 10uF; C_0805_2012Metric; LCSC C15850
C73, C75: 1uF; C_0603_1608Metric; LCSC C29936
D13: green; LED_0603_1608Metric; LCSC C965805
FB2, FB3: BLM18KG601SN1D; L_0603_1608Metric; LCSC C85833
J14: FT_3V3; PinHeader_1x03_P2.54mm_Vertical; LCSC C49257
R52: 12k; R_0603_1608Metric; LCSC C22790
R53: 2.2k; R_0603_1608Metric; LCSC C4190
R54: 10k; R_0603_1608Metric; LCSC C25804
R55: 470; R_0603_1608Metric; LCSC C23179
TP25: VCORE; TestPoint_Pad_D1.5mm
TP26: VCC3; TestPoint_Pad_D1.5mm
TP27: GND; TestPoint_Pad_D1.5mm
U1: FT4232HL; LQFP-64_10x10mm_P0.5mm; LCSC C56742
U10, U11: MAX3232EIDR; SOIC-16_3.9x9.9mm_P1.27mm; LCSC C193666
U31: 93LC46BT-I/SN; SOIC-8_3.9x4.9mm_P1.27mm; LCSC C16253
X2: 12MHz; Crystal_SMD_3225-4Pin_3.2x2.5mm; LCSC C9002

Connections:
+3.3V: J14.1; also elsewhere on the board
/FT1/C1N_AB: C76.2, U10.3 (C1-)
/FT1/C1N_CD: C81.2, U11.3 (C1-)
/FT1/C1P_AB: C76.1, U10.1 (C1+)
/FT1/C1P_CD: C81.1, U11.1 (C1+)
/FT1/C2N_AB: C77.2, U10.5 (C2-)
/FT1/C2N_CD: C82.2, U11.5 (C2-)
/FT1/C2P_AB: C77.1, U10.4 (C2+)
/FT1/C2P_CD: C82.1, U11.4 (C2+)
/FT1/EECLK: U1.62 (EECLK), U31.2 (CLK)
/FT1/EECS: U1.63 (EECS), U31.1 (CS)
/FT1/EEDATA: R53.2, U1.61 (EEDATA), U31.3 (DI)
/FT1/EE_DO: R53.1, R54.2, U31.4 (DO)
/FT1/LEDA_FT: D13.2 (A), R55.2
/FT1/OSCI: C57.1, U1.2 (OSCI), X2.1
/FT1/OSCO: C58.1, U1.3 (OSCO), X2.3
/FT1/REF: R52.1, U1.6 (REF)
/FT1/RXD_A: U1.17 (ADBUS1), U10.12 (R1OUT)
/FT1/RXD_B: U1.27 (BDBUS1), U10.9 (R2OUT)
/FT1/RXD_C: U1.39 (CDBUS1), U11.12 (R1OUT)
/FT1/RXD_D: U1.52 (DDBUS1), U11.9 (R2OUT)
/FT1/TXD_A: U1.16 (ADBUS0), U10.11 (T1IN)
/FT1/TXD_B: U1.26 (BDBUS0), U10.10 (T2IN)
/FT1/TXD_C: U1.38 (CDBUS0), U11.11 (T1IN)
/FT1/TXD_D: U1.48 (DDBUS0), U11.10 (T2IN)
/FT1/VCC3: C59.1, C60.1, C67.1, C68.1, C69.1, C70.1, C71.1, C80.1, C85.1, FB2.1, FB3.1, J14.2, R54.1, R55.1, TP26.1, U1.20 (VCCIO), U1.31 (VCCIO), U1.42 (VCCIO), U1.50 (VREGIN), U1.56 (VCCIO), U10.16 (VCC), U11.16 (VCC), U31.8 (VCC)
/FT1/VCORE: C61.1, C64.1, C65.1, C66.1, TP25.1, U1.12 (VCORE), U1.37 (VCORE), U1.49 (VREGOUT), U1.64 (VCORE)
/FT1/VN_AB: C79.2, U10.6 (VS-)
/FT1/VN_CD: C84.2, U11.6 (VS-)
/FT1/VPHY: C74.1, C75.1, FB3.2, U1.4 (VPHY)
/FT1/VPLL: C72.1, C73.1, FB2.2, U1.9 (VPLL)
/FT1/VP_AB: C78.1, U10.2 (VS+)
/FT1/VP_CD: C83.1, U11.2 (VS+)
FTDI_RST_N: U1.14 (~RESET); also elsewhere on the board
GND: C57.2, C58.2, C59.2, C60.2, C61.2, C64.2, C65.2, C66.2, C67.2, C68.2, C69.2, C70.2, C71.2, C72.2, C73.2, C74.2, C75.2, C78.2, C79.1, C80.2, C83.2, C84.1, C85.2, D13.1 (K), J14.3, R52.2, TP27.1, U1.1 (GND), U1.5 (GND), U1.10 (AGND), U1.11 (GND), U1.13 (TEST), U1.15 (GND), U1.25 (GND), U1.35 (GND), U1.47 (GND), U1.51 (GND), U10.15 (GND), U11.15 (GND), U31.5 (VSS), X2.2 (G), X2.4 (G); also elsewhere on the board
P01_RXD: U10.13 (R1IN); also elsewhere on the board
P01_TXD: U10.14 (T1OUT); also elsewhere on the board
P02_RXD: U10.8 (R2IN); also elsewhere on the board
P02_TXD: U10.7 (T2OUT); also elsewhere on the board
P03_RXD: U11.13 (R1IN); also elsewhere on the board
P03_TXD: U11.14 (T1OUT); also elsewhere on the board
P04_RXD: U11.8 (R2IN); also elsewhere on the board
P04_TXD: U11.7 (T2OUT); also elsewhere on the board
USB_DN1_DM: U1.7 (DM); also elsewhere on the board
USB_DN1_DP: U1.8 (DP); also elsewhere on the board

Parts of its further copies:
C86, C87, C113, C114, C140, C141: 33pF; C_0603_1608Metric; LCSC C1663
C88, C89, C91, C92, C93, C94, C95, C96, C97, C99, C101, C103, C104, C105, C106, C107, C108, C109, C110, C111, C112, C115, C116, C118, C119, C120, C121, C122, C123, C124, C126, C128, C130, C131, C132, C133, C134, C135, C136, C137, C138, C139, C142, C143, C145, C146, C147, C148, C149, C150, C151, C153, C155, C157, C158, C159, C160, C161, C162, C163, C164, C165, C166: 100nF; C_0603_1608Metric; LCSC C14663
C90, C117, C144: 4.7uF; C_0805_2012Metric; LCSC C1779
C98, C125, C152: 10uF; C_0805_2012Metric; LCSC C15850
C100, C102, C127, C129, C154, C156: 1uF; C_0603_1608Metric; LCSC C29936
D14, D15, D16: green; LED_0603_1608Metric; LCSC C965805
FB4, FB5, FB6, FB7, FB8, FB9: BLM18KG601SN1D; L_0603_1608Metric; LCSC C85833
J15, J16, J17: FT_3V3; PinHeader_1x03_P2.54mm_Vertical; LCSC C49257
R56, R60, R64: 12k; R_0603_1608Metric; LCSC C22790
R57, R61, R65: 2.2k; R_0603_1608Metric; LCSC C4190
R58, R62, R66: 10k; R_0603_1608Metric; LCSC C25804
R59, R63, R67: 470; R_0603_1608Metric; LCSC C23179
TP28, TP31, TP34: VCORE; TestPoint_Pad_D1.5mm
TP29, TP32, TP35: VCC3; TestPoint_Pad_D1.5mm
TP30, TP33, TP36: GND; TestPoint_Pad_D1.5mm
U2, U3, U4: FT4232HL; LQFP-64_10x10mm_P0.5mm; LCSC C56742
U12, U13, U14, U15, U16, U17: MAX3232EIDR; SOIC-16_3.9x9.9mm_P1.27mm; LCSC C193666
U32, U33, U34: 93LC46BT-I/SN; SOIC-8_3.9x4.9mm_P1.27mm; LCSC C16253
X3, X4, X5: 12MHz; Crystal_SMD_3225-4Pin_3.2x2.5mm; LCSC C9002

Connections of its further copies:
+3.3V: J15.1, J16.1, J17.1; also elsewhere on the board
/FT2/C1N_AB: C103.2, U12.3 (C1-)
/FT2/C1N_CD: C108.2, U13.3 (C1-)
/FT2/C1P_AB: C103.1, U12.1 (C1+)
/FT2/C1P_CD: C108.1, U13.1 (C1+)
/FT2/C2N_AB: C104.2, U12.5 (C2-)
/FT2/C2N_CD: C109.2, U13.5 (C2-)
/FT2/C2P_AB: C104.1, U12.4 (C2+)
/FT2/C2P_CD: C109.1, U13.4 (C2+)
/FT2/EECLK: U2.62 (EECLK), U32.2 (CLK)
/FT2/EECS: U2.63 (EECS), U32.1 (CS)
/FT2/EEDATA: R57.2, U2.61 (EEDATA), U32.3 (DI)
/FT2/EE_DO: R57.1, R58.2, U32.4 (DO)
/FT2/LEDA_FT: D14.2 (A), R59.2
/FT2/OSCI: C86.1, U2.2 (OSCI), X3.1
/FT2/OSCO: C87.1, U2.3 (OSCO), X3.3
/FT2/REF: R56.1, U2.6 (REF)
/FT2/RXD_A: U2.17 (ADBUS1), U12.12 (R1OUT)
/FT2/RXD_B: U2.27 (BDBUS1), U12.9 (R2OUT)
/FT2/RXD_C: U2.39 (CDBUS1), U13.12 (R1OUT)
/FT2/RXD_D: U2.52 (DDBUS1), U13.9 (R2OUT)
/FT2/TXD_A: U2.16 (ADBUS0), U12.11 (T1IN)
/FT2/TXD_B: U2.26 (BDBUS0), U12.10 (T2IN)
/FT2/TXD_C: U2.38 (CDBUS0), U13.11 (T1IN)
/FT2/TXD_D: U2.48 (DDBUS0), U13.10 (T2IN)
/FT2/VCC3: C88.1, C89.1, C94.1, C95.1, C96.1, C97.1, C98.1, C107.1, C112.1, FB4.1, FB5.1, J15.2, R58.1, R59.1, TP29.1, U2.20 (VCCIO), U2.31 (VCCIO), U2.42 (VCCIO), U2.50 (VREGIN), U2.56 (VCCIO), U12.16 (VCC), U13.16 (VCC), U32.8 (VCC)
/FT2/VCORE: C90.1, C91.1, C92.1, C93.1, TP28.1, U2.12 (VCORE), U2.37 (VCORE), U2.49 (VREGOUT), U2.64 (VCORE)
/FT2/VN_AB: C106.2, U12.6 (VS-)
/FT2/VN_CD: C111.2, U13.6 (VS-)
/FT2/VPHY: C101.1, C102.1, FB5.2, U2.4 (VPHY)
/FT2/VPLL: C99.1, C100.1, FB4.2, U2.9 (VPLL)
/FT2/VP_AB: C105.1, U12.2 (VS+)
/FT2/VP_CD: C110.1, U13.2 (VS+)
/FT3/C1N_AB: C130.2, U14.3 (C1-)
/FT3/C1N_CD: C135.2, U15.3 (C1-)
/FT3/C1P_AB: C130.1, U14.1 (C1+)
/FT3/C1P_CD: C135.1, U15.1 (C1+)
/FT3/C2N_AB: C131.2, U14.5 (C2-)
/FT3/C2N_CD: C136.2, U15.5 (C2-)
/FT3/C2P_AB: C131.1, U14.4 (C2+)
/FT3/C2P_CD: C136.1, U15.4 (C2+)
/FT3/EECLK: U3.62 (EECLK), U33.2 (CLK)
/FT3/EECS: U3.63 (EECS), U33.1 (CS)
/FT3/EEDATA: R61.2, U3.61 (EEDATA), U33.3 (DI)
/FT3/EE_DO: R61.1, R62.2, U33.4 (DO)
/FT3/LEDA_FT: D15.2 (A), R63.2
/FT3/OSCI: C113.1, U3.2 (OSCI), X4.1
/FT3/OSCO: C114.1, U3.3 (OSCO), X4.3
/FT3/REF: R60.1, U3.6 (REF)
/FT3/RXD_A: U3.17 (ADBUS1), U14.12 (R1OUT)
/FT3/RXD_B: U3.27 (BDBUS1), U14.9 (R2OUT)
/FT3/RXD_C: U3.39 (CDBUS1), U15.12 (R1OUT)
/FT3/RXD_D: U3.52 (DDBUS1), U15.9 (R2OUT)
/FT3/TXD_A: U3.16 (ADBUS0), U14.11 (T1IN)
/FT3/TXD_B: U3.26 (BDBUS0), U14.10 (T2IN)
/FT3/TXD_C: U3.38 (CDBUS0), U15.11 (T1IN)
/FT3/TXD_D: U3.48 (DDBUS0), U15.10 (T2IN)
/FT3/VCC3: C115.1, C116.1, C121.1, C122.1, C123.1, C124.1, C125.1, C134.1, C139.1, FB6.1, FB7.1, J16.2, R62.1, R63.1, TP32.1, U3.20 (VCCIO), U3.31 (VCCIO), U3.42 (VCCIO), U3.50 (VREGIN), U3.56 (VCCIO), U14.16 (VCC), U15.16 (VCC), U33.8 (VCC)
/FT3/VCORE: C117.1, C118.1, C119.1, C120.1, TP31.1, U3.12 (VCORE), U3.37 (VCORE), U3.49 (VREGOUT), U3.64 (VCORE)
/FT3/VN_AB: C133.2, U14.6 (VS-)
/FT3/VN_CD: C138.2, U15.6 (VS-)
/FT3/VPHY: C128.1, C129.1, FB7.2, U3.4 (VPHY)
/FT3/VPLL: C126.1, C127.1, FB6.2, U3.9 (VPLL)
/FT3/VP_AB: C132.1, U14.2 (VS+)
/FT3/VP_CD: C137.1, U15.2 (VS+)
/FT4/C1N_AB: C157.2, U16.3 (C1-)
/FT4/C1N_CD: C162.2, U17.3 (C1-)
/FT4/C1P_AB: C157.1, U16.1 (C1+)
/FT4/C1P_CD: C162.1, U17.1 (C1+)
/FT4/C2N_AB: C158.2, U16.5 (C2-)
/FT4/C2N_CD: C163.2, U17.5 (C2-)
/FT4/C2P_AB: C158.1, U16.4 (C2+)
/FT4/C2P_CD: C163.1, U17.4 (C2+)
/FT4/EECLK: U4.62 (EECLK), U34.2 (CLK)
/FT4/EECS: U4.63 (EECS), U34.1 (CS)
/FT4/EEDATA: R65.2, U4.61 (EEDATA), U34.3 (DI)
/FT4/EE_DO: R65.1, R66.2, U34.4 (DO)
/FT4/LEDA_FT: D16.2 (A), R67.2
/FT4/OSCI: C140.1, U4.2 (OSCI), X5.1
/FT4/OSCO: C141.1, U4.3 (OSCO), X5.3
/FT4/REF: R64.1, U4.6 (REF)
/FT4/RXD_A: U4.17 (ADBUS1), U16.12 (R1OUT)
/FT4/RXD_B: U4.27 (BDBUS1), U16.9 (R2OUT)
/FT4/RXD_C: U4.39 (CDBUS1), U17.12 (R1OUT)
/FT4/RXD_D: U4.52 (DDBUS1), U17.9 (R2OUT)
/FT4/TXD_A: U4.16 (ADBUS0), U16.11 (T1IN)
/FT4/TXD_B: U4.26 (BDBUS0), U16.10 (T2IN)
/FT4/TXD_C: U4.38 (CDBUS0), U17.11 (T1IN)
/FT4/TXD_D: U4.48 (DDBUS0), U17.10 (T2IN)
/FT4/VCC3: C142.1, C143.1, C148.1, C149.1, C150.1, C151.1, C152.1, C161.1, C166.1, FB8.1, FB9.1, J17.2, R66.1, R67.1, TP35.1, U4.20 (VCCIO), U4.31 (VCCIO), U4.42 (VCCIO), U4.50 (VREGIN), U4.56 (VCCIO), U16.16 (VCC), U17.16 (VCC), U34.8 (VCC)
/FT4/VCORE: C144.1, C145.1, C146.1, C147.1, TP34.1, U4.12 (VCORE), U4.37 (VCORE), U4.49 (VREGOUT), U4.64 (VCORE)
/FT4/VN_AB: C160.2, U16.6 (VS-)
/FT4/VN_CD: C165.2, U17.6 (VS-)
/FT4/VPHY: C155.1, C156.1, FB9.2, U4.4 (VPHY)
/FT4/VPLL: C153.1, C154.1, FB8.2, U4.9 (VPLL)
/FT4/VP_AB: C159.1, U16.2 (VS+)
/FT4/VP_CD: C164.1, U17.2 (VS+)
FTDI_RST_N: U2.14 (~RESET), U3.14 (~RESET), U4.14 (~RESET); also elsewhere on the board
GND: C86.2, C87.2, C88.2, C89.2, C90.2, C91.2, C92.2, C93.2, C94.2, C95.2, C96.2, C97.2, C98.2, C99.2, C100.2, C101.2, C102.2, C105.2, C106.1, C107.2, C110.2, C111.1, C112.2, C113.2, C114.2, C115.2, C116.2, C117.2, C118.2, C119.2, C120.2, C121.2, C122.2, C123.2, C124.2, C125.2, C126.2, C127.2, C128.2, C129.2, C132.2, C133.1, C134.2, C137.2, C138.1, C139.2, C140.2, C141.2, C142.2, C143.2, C144.2, C145.2, C146.2, C147.2, C148.2, C149.2, C150.2, C151.2, C152.2, C153.2, C154.2, C155.2, C156.2, C159.2, C160.1, C161.2, C164.2, C165.1, C166.2, D14.1 (K), D15.1 (K), D16.1 (K), J15.3, J16.3, J17.3, R56.2, R60.2, R64.2, TP30.1, TP33.1, TP36.1, U2.1 (GND), U2.5 (GND), U2.10 (AGND), U2.11 (GND), U2.13 (TEST), U2.15 (GND), U2.25 (GND), U2.35 (GND), U2.47 (GND), U2.51 (GND), U3.1 (GND), U3.5 (GND), U3.10 (AGND), U3.11 (GND), U3.13 (TEST), U3.15 (GND), U3.25 (GND), U3.35 (GND), U3.47 (GND), U3.51 (GND), U4.1 (GND), U4.5 (GND), U4.10 (AGND), U4.11 (GND), U4.13 (TEST), U4.15 (GND), U4.25 (GND), U4.35 (GND), U4.47 (GND), U4.51 (GND), U12.15 (GND), U13.15 (GND), U14.15 (GND), U15.15 (GND), U16.15 (GND), U17.15 (GND), U32.5 (VSS), U33.5 (VSS), U34.5 (VSS), X3.2 (G), X3.4 (G), X4.2 (G), X4.4 (G), X5.2 (G), X5.4 (G); also elsewhere on the board
P05_RXD: U12.13 (R1IN); also elsewhere on the board
P05_TXD: U12.14 (T1OUT); also elsewhere on the board
P06_RXD: U12.8 (R2IN); also elsewhere on the board
P06_TXD: U12.7 (T2OUT); also elsewhere on the board
P07_RXD: U13.13 (R1IN); also elsewhere on the board
P07_TXD: U13.14 (T1OUT); also elsewhere on the board
P08_RXD: U13.8 (R2IN); also elsewhere on the board
P08_TXD: U13.7 (T2OUT); also elsewhere on the board
P09_RXD: U14.13 (R1IN); also elsewhere on the board
P09_TXD: U14.14 (T1OUT); also elsewhere on the board
P10_RXD: U14.8 (R2IN); also elsewhere on the board
P10_TXD: U14.7 (T2OUT); also elsewhere on the board
P11_RXD: U15.13 (R1IN); also elsewhere on the board
P11_TXD: U15.14 (T1OUT); also elsewhere on the board
P12_RXD: U15.8 (R2IN); also elsewhere on the board
P12_TXD: U15.7 (T2OUT); also elsewhere on the board
P13_RXD: U16.13 (R1IN); also elsewhere on the board
P13_TXD: U16.14 (T1OUT); also elsewhere on the board
P14_RXD: U16.8 (R2IN); also elsewhere on the board
P14_TXD: U16.7 (T2OUT); also elsewhere on the board
P15_RXD: U17.13 (R1IN); also elsewhere on the board
P15_TXD: U17.14 (T1OUT); also elsewhere on the board
P16_RXD: U17.8 (R2IN); also elsewhere on the board
P16_TXD: U17.7 (T2OUT); also elsewhere on the board
USB_DN2_DM: U2.7 (DM); also elsewhere on the board
USB_DN2_DP: U2.8 (DP); also elsewhere on the board
USB_DN3_DM: U3.7 (DM); also elsewhere on the board
USB_DN3_DP: U3.8 (DP); also elsewhere on the board
USB_DN4_DM: U4.7 (DM); also elsewhere on the board
USB_DN4_DP: U4.8 (DP); also elsewhere on the board

Notes on the sheet:
TP: 1.8 V core, cluster 3.3 V, GND
CLUSTER BRING-UP HEADER (Rev B): 1 = +3.3V, 2 = VCC3 (this cluster), 3 = GND. Jumper 1-2 = normal. Pull it to leave this cluster dark; meter across 1-2 for its current; bench supply on 2-3.
RS-232: MAX3232E (+-15 kV ESD, 250 kbit/s guaranteed). 3-wire: the Cisco console port ignores RTS/CTS. Flying caps and V+/V- reservoirs tight to the chip - that is the only layout rule.
ONE OF FOUR IDENTICAL CLUSTERS. Compound device: no VBUS at the FTDI, no VBUS divider into RESET#. VREGOUT -> VCORE is an EXTERNAL connection (4.7 uF compensates the internal LDO). VPLL and VPHY are 3.3 V, each on its own ferrite. All four VCCIO pins must be connected. TEST hard to GND (floating = 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
