TheKingOfChaos/Console-Server/usb-console-server.kicad_pcb

## KiCad design usb-console-server.kicad_pcb (continued)

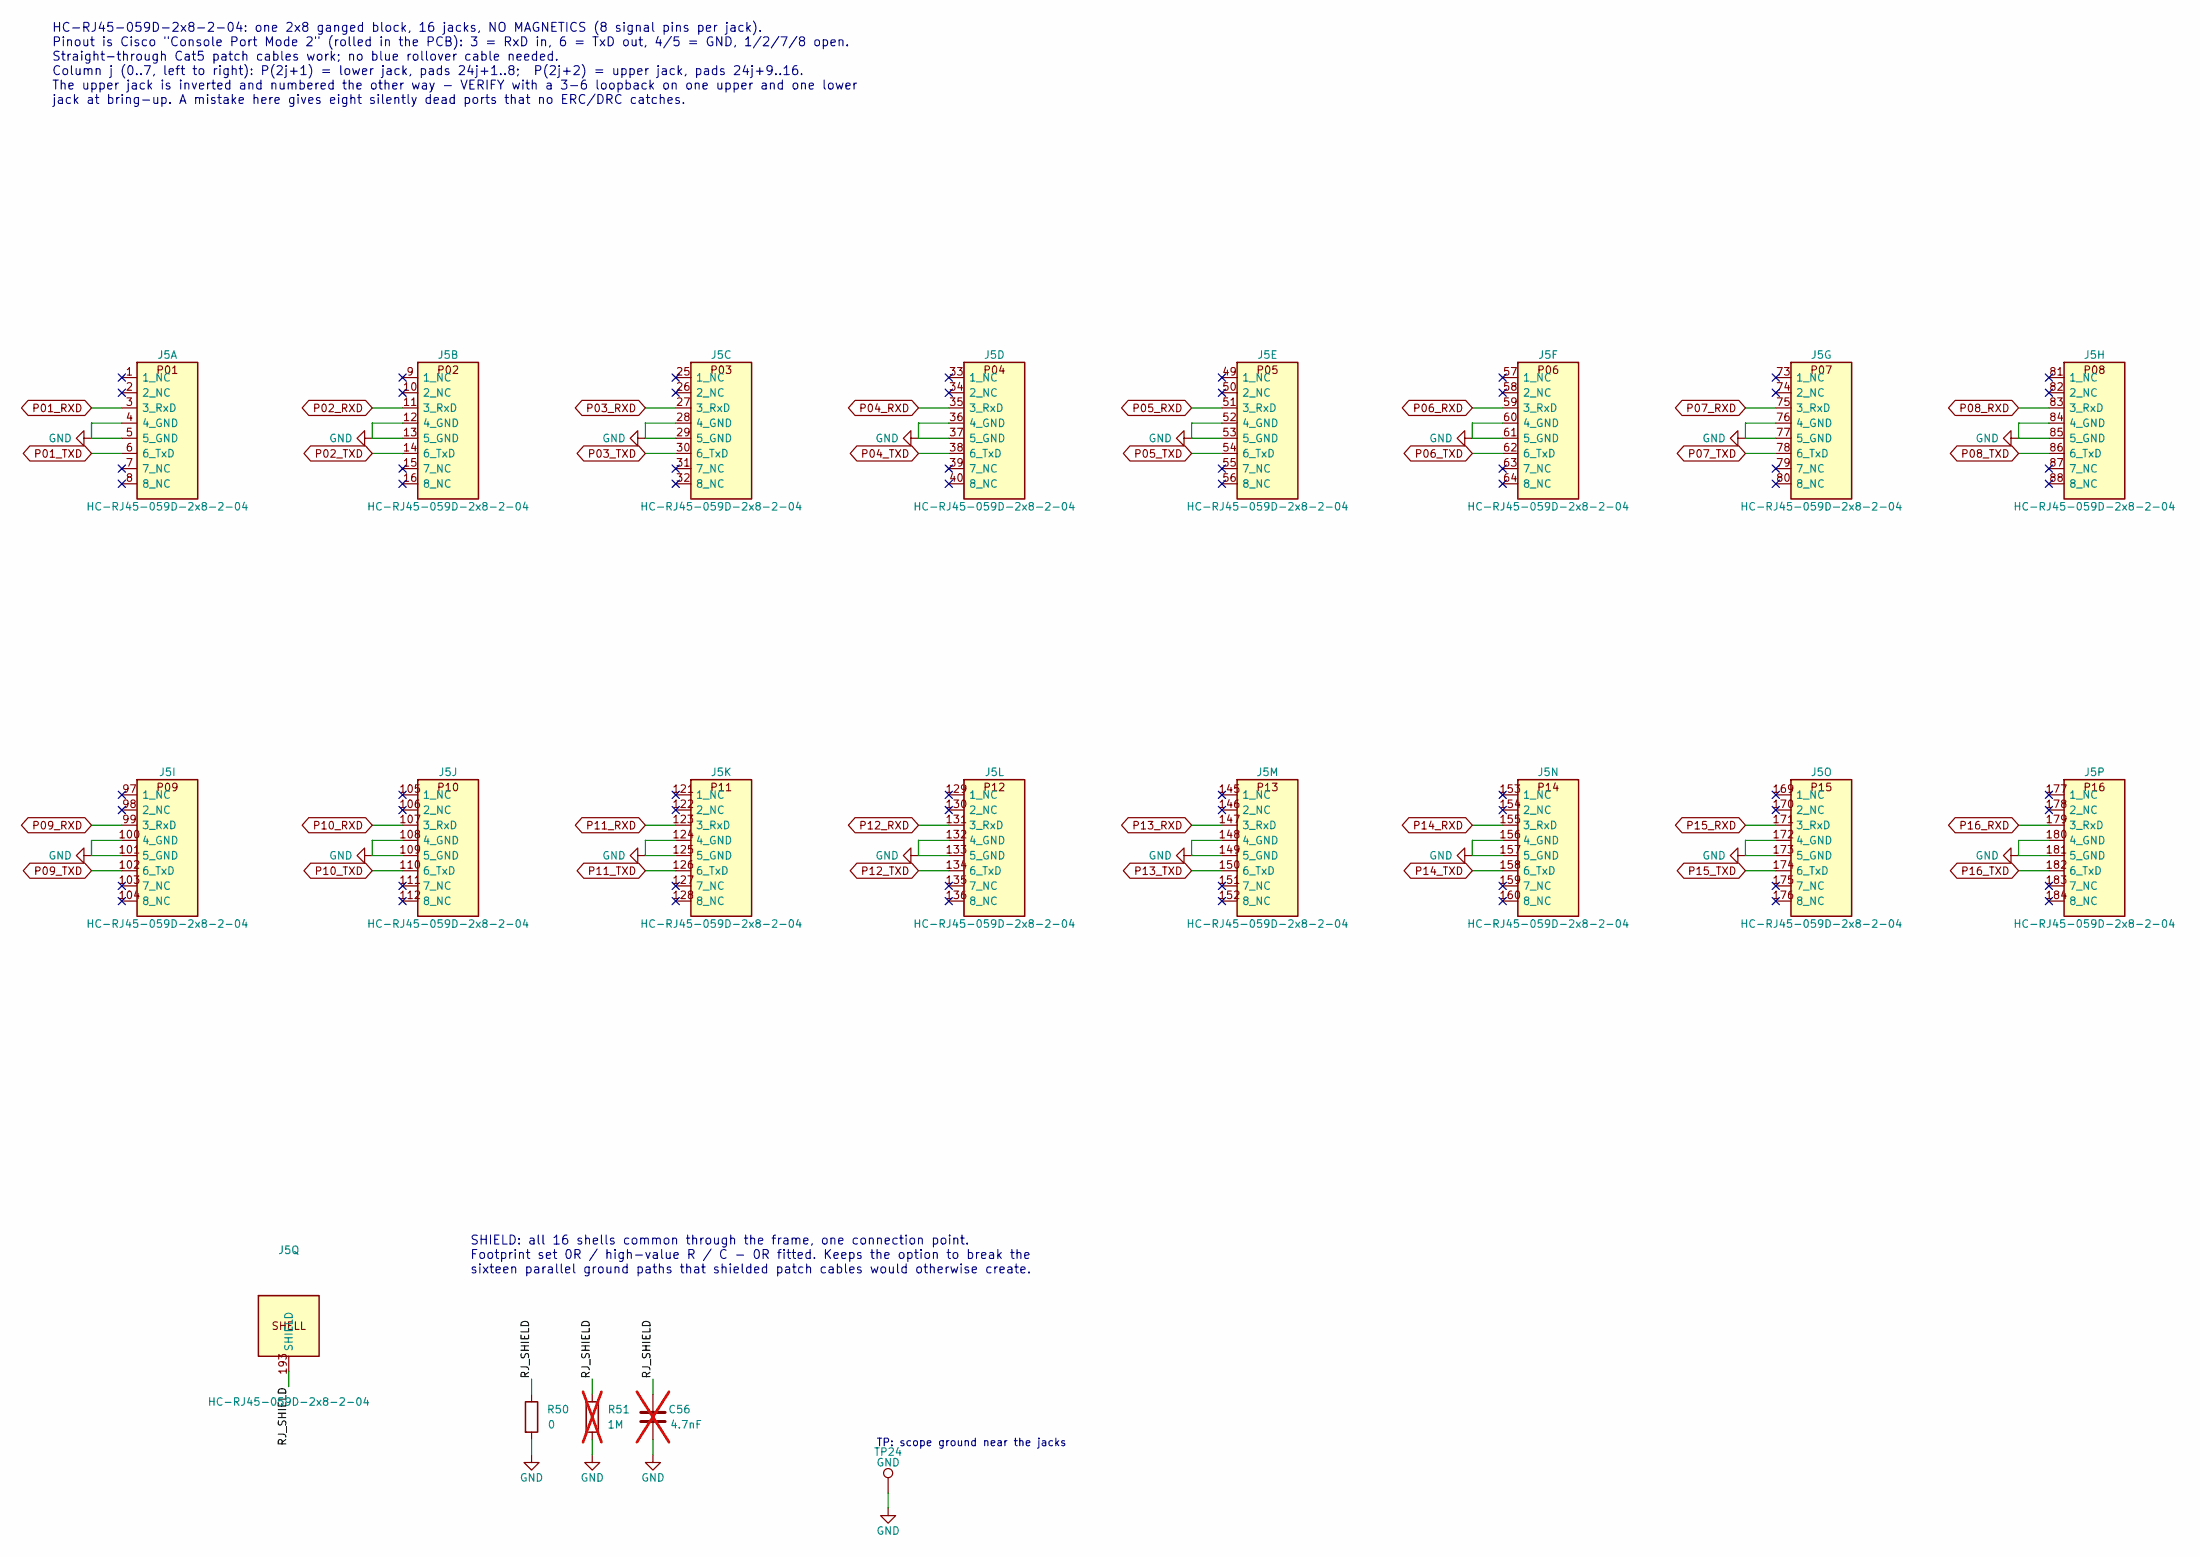
[picture p6: schematic ports.kicad_sch, RS-232 console ports P01-P16]

Parts:
C56: 4.7nF; C_0603_1608Metric; LCSC C53987; not fitted
J5: HC-RJ45-059D-2x8-2-04; RJ45_HC-RJ45-059D-2x8; LCSC C46261623
R50: 0; R_0603_1608Metric; LCSC C21189
R51: 1M; R_0603_1608Metric; LCSC C22935; not fitted
TP24: GND; TestPoint_Pad_D1.5mm

Connections:
/Ports/RJ_SHIELD: C56.1, J5.193 (SHIELD), J5.194 (SHIELD), J5.195 (SHIELD), J5.196 (SHIELD), R50.1, R51.1
GND: C56.2, J5.4 (4_GND), J5.5 (5_GND), J5.12 (4_GND), J5.13 (5_GND), J5.28 (4_GND), J5.29 (5_GND), J5.36 (4_GND), J5.37 (5_GND), J5.52 (4_GND), J5.53 (5_GND), J5.60 (4_GND), J5.61 (5_GND), J5.76 (4_GND), J5.77 (5_GND), J5.84 (4_GND), J5.85 (5_GND), J5.100 (4_GND), J5.101 (5_GND), J5.108 (4_GND), J5.109 (5_GND), J5.124 (4_GND), J5.125 (5_GND), J5.132 (4_GND), J5.133 (5_GND), J5.148 (4_GND), J5.149 (5_GND), J5.156 (4_GND), J5.157 (5_GND), J5.172 (4_GND), J5.173 (5_GND), J5.180 (4_GND), J5.181 (5_GND), R50.2, R51.2, TP24.1; also elsewhere on the board
P01_RXD: J5.3 (3_RxD); also elsewhere on the board
P01_TXD: J5.6 (6_TxD); also elsewhere on the board
P02_RXD: J5.11 (3_RxD); also elsewhere on the board
P02_TXD: J5.14 (6_TxD); also elsewhere on the board
P03_RXD: J5.27 (3_RxD); also elsewhere on the board
P03_TXD: J5.30 (6_TxD); also elsewhere on the board
P04_RXD: J5.35 (3_RxD); also elsewhere on the board
P04_TXD: J5.38 (6_TxD); also elsewhere on the board
P05_RXD: J5.51 (3_RxD); also elsewhere on the board
P05_TXD: J5.54 (6_TxD); also elsewhere on the board
P06_RXD: J5.59 (3_RxD); also elsewhere on the board
P06_TXD: J5.62 (6_TxD); also elsewhere on the board
P07_RXD: J5.75 (3_RxD); also elsewhere on the board
P07_TXD: J5.78 (6_TxD); also elsewhere on the board
P08_RXD: J5.83 (3_RxD); also elsewhere on the board
P08_TXD: J5.86 (6_TxD); also elsewhere on the board
P09_RXD: J5.99 (3_RxD); also elsewhere on the board
P09_TXD: J5.102 (6_TxD); also elsewhere on the board
P10_RXD: J5.107 (3_RxD); also elsewhere on the board
P10_TXD: J5.110 (6_TxD); also elsewhere on the board
P11_RXD: J5.123 (3_RxD); also elsewhere on the board
P11_TXD: J5.126 (6_TxD); also elsewhere on the board
P12_RXD: J5.131 (3_RxD); also elsewhere on the board
P12_TXD: J5.134 (6_TxD); also elsewhere on the board
P13_RXD: J5.147 (3_RxD); also elsewhere on the board
P13_TXD: J5.150 (6_TxD); also elsewhere on the board
P14_RXD: J5.155 (3_RxD); also elsewhere on the board
P14_TXD: J5.158 (6_TxD); also elsewhere on the board
P15_RXD: J5.171 (3_RxD); also elsewhere on the board
P15_TXD: J5.174 (6_TxD); also elsewhere on the board
P16_RXD: J5.179 (3_RxD); also elsewhere on the board
P16_TXD: J5.182 (6_TxD); also elsewhere on the board

Notes on the sheet:
HC-RJ45-059D-2x8-2-04: one 2x8 ganged block, 16 jacks, NO MAGNETICS (8 signal pins per jack). Pinout is Cisco "Console Port Mode 2" (rolled in the PCB): 3 = RxD in, 6 = TxD out, 4/5 = GND, 1/2/7/8 open. Straight-through Cat5 patch cables work; no blue rollover cable needed. Column j (0..7, left to 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
TP: scope ground near the jacks
SHIELD: all 16 shells common through the frame, one connection point. Footprint set 0R / high-value R / C - 0R fitted. Keeps the option to break the sixteen parallel ground paths that shielded patch cables would otherwise create.

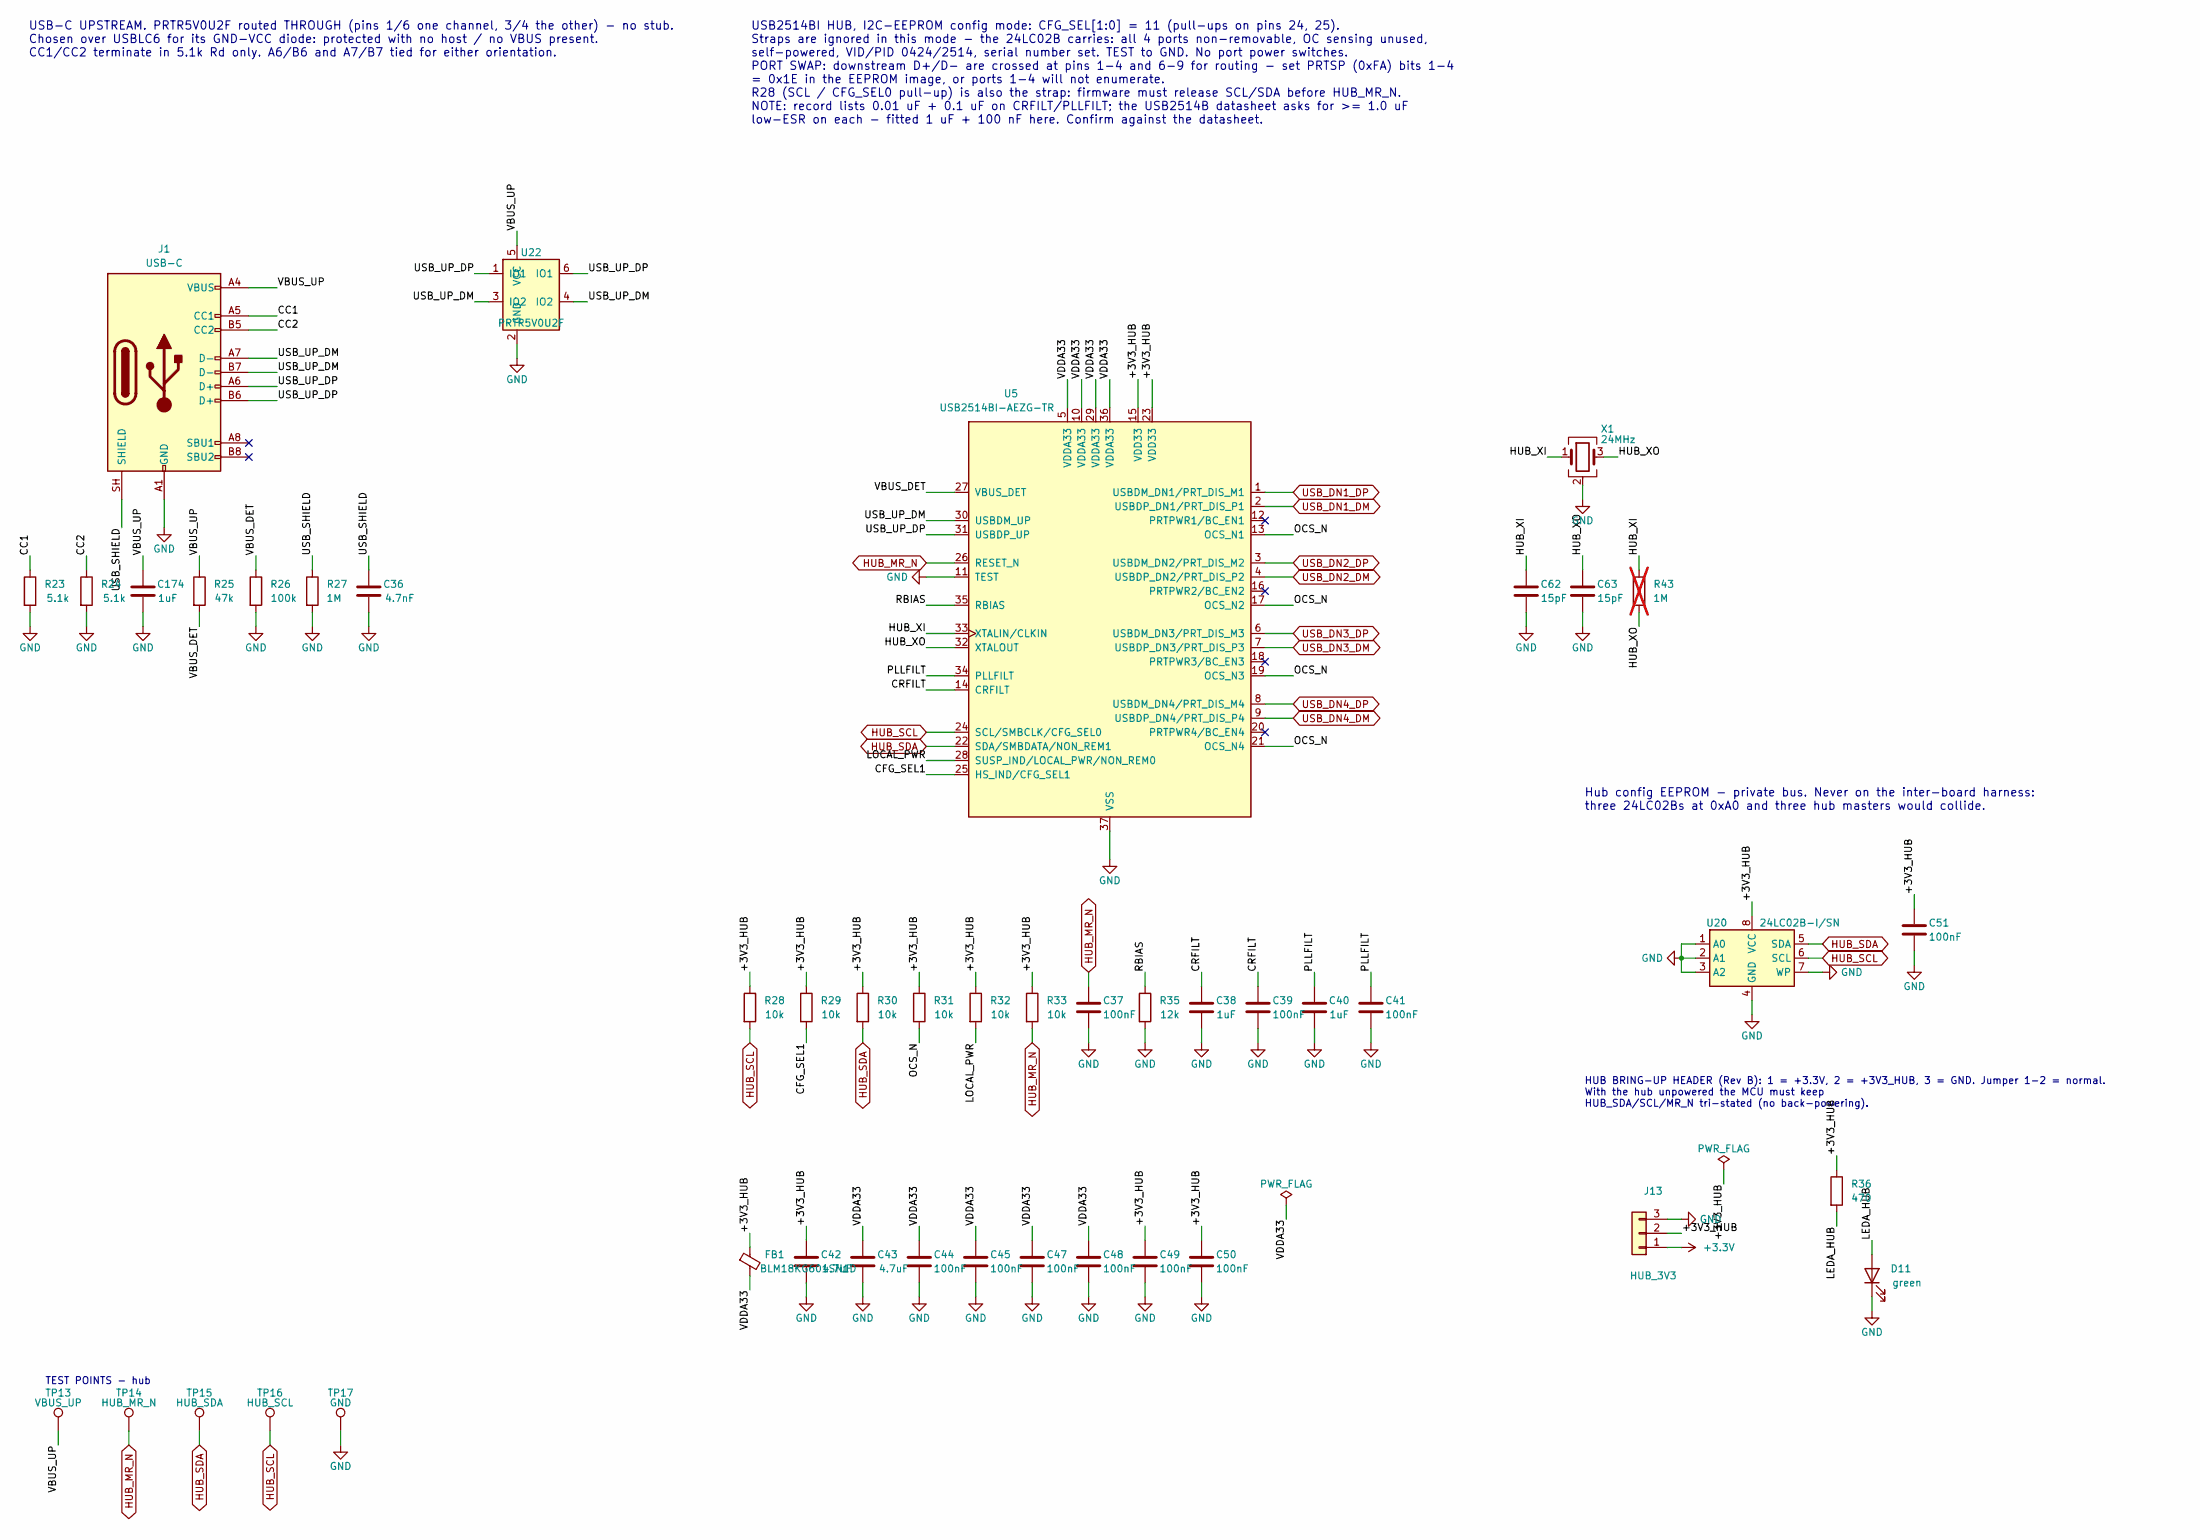
[picture p7: schematic hub.kicad_sch, USB upstream and hub]

Parts:
C36: 4.7nF; C_0603_1608Metric; LCSC C53987
C37, C39, C41, C44, C45, C47, C48, C49, C50, C51: 100nF; C_0603_1608Metric; LCSC C14663
C38, C40: 1uF; C_0603_1608Metric; LCSC C29936
C42, C43: 4.7uF; C_0805_2012Metric; LCSC C1779
C62, C63: 15pF; C_0603_1608Metric; LCSC C1644
C174: 1uF; C_0805_2012Metric; LCSC C91185
D11: green; LED_0603_1608Metric; LCSC C965805
FB1: BLM18KG601SN1D; L_0603_1608Metric; LCSC C85833
J1: USB-C; USB_C_Receptacle_HRO_TYPE-C-31-M-12; LCSC C165948
J13: HUB_3V3; PinHeader_1x03_P2.54mm_Vertical; LCSC C49257
R23, R24: 5.1k; R_0603_1608Metric; LCSC C23186
R25: 47k; R_0603_1608Metric; LCSC C111134
R26: 100k; R_0603_1608Metric; LCSC C25803
R27: 1M; R_0603_1608Metric; LCSC C22935
R28, R29, R30, R31, R32, R33: 10k; R_0603_1608Metric; LCSC C25804
R35: 12k; R_0603_1608Metric; LCSC C22790
R36: 470; R_0603_1608Metric; LCSC C23179
R43: 1M; R_0603_1608Metric; LCSC C22935; not fitted
TP13: VBUS_UP; TestPoint_Pad_D1.5mm
TP14: HUB_MR_N; TestPoint_Pad_D1.0mm
TP15: HUB_SDA; TestPoint_Pad_D1.0mm
TP16: HUB_SCL; TestPoint_Pad_D1.0mm
TP17: GND; TestPoint_Pad_D1.5mm
U5: USB2514BI-AEZG-TR; QFN-36-1EP_6x6mm_P0.5mm_EP3.7x3.7mm; LCSC C58940
U20: 24LC02B-I/SN; SOIC-8_3.9x4.9mm_P1.27mm; LCSC C1348870
U22: PRTR5V0U2F; SOT886_L1.5-W1.0-P0.50-LS1.00-BL; LCSC C478118
X1: 24MHz; Crystal_SMD_3225-4Pin_3.2x2.5mm; LCSC C5444545

Connections:
+3.3V: J13.1; also elsewhere on the board
/USB hub/+3V3_HUB: C42.1, C49.1, C50.1, C51.1, FB1.1, J13.2, R28.1, R29.1, R30.1, R31.1, R32.1, R33.1, R36.1, U5.15 (VDD33), U5.23 (VDD33), U20.8 (VCC)
/USB hub/CC1: J1.A5 (CC1), R23.1
/USB hub/CC2: J1.B5 (CC2), R24.1
/USB hub/CFG_SEL1: R29.2, U5.25 (HS_IND/CFG_SEL1)
/USB hub/CRFILT: C38.1, C39.1, U5.14 (CRFILT)
/USB hub/HUB_XI: C62.1, R43.1, U5.33 (XTALIN/CLKIN), X1.1
/USB hub/HUB_XO: C63.1, R43.2, U5.32 (XTALOUT), X1.3
/USB hub/LEDA_HUB: D11.2 (A), R36.2
/USB hub/LOCAL_PWR: R32.2, U5.28 (SUSP_IND/LOCAL_PWR/NON_REM0)
/USB hub/OCS_N: R31.2, U5.13 (OCS_N1), U5.17 (OCS_N2), U5.19 (OCS_N3), U5.21 (OCS_N4)
/USB hub/PLLFILT: C40.1, C41.1, U5.34 (PLLFILT)
/USB hub/RBIAS: R35.1, U5.35 (RBIAS)
/USB hub/USB_SHIELD: C36.1, J1.SH (SHIELD), R27.1
/USB hub/USB_UP_DM: J1.A7 (D-), J1.B7 (D-), U5.30 (USBDM_UP), U22.3 (IO2), U22.4 (IO2)
/USB hub/USB_UP_DP: J1.A6 (D+), J1.B6 (D+), U5.31 (USBDP_UP), U22.1 (IO1), U22.6 (IO1)
/USB hub/VBUS_DET: R25.2, R26.1, U5.27 (VBUS_DET)
/USB hub/VBUS_UP: C174.1, J1.A4 (VBUS), J1.A9 (VBUS), J1.B4 (VBUS), J1.B9 (VBUS), R25.1, TP13.1, U22.5 (VCC)
/USB hub/VDDA33: C43.1, C44.1, C45.1, C47.1, C48.1, FB1.2, U5.5 (VDDA33), U5.10 (VDDA33), U5.29 (VDDA33), U5.36 (VDDA33)
GND: C36.2, C37.2, C38.2, C39.2, C40.2, C41.2, C42.2, C43.2, C44.2, C45.2, C47.2, C48.2, C49.2, C50.2, C51.2, C62.2, C63.2, C174.2, D11.1 (K), J1.A1 (GND), J1.A12 (GND), J1.B1 (GND), J1.B12 (GND), J13.3, R23.2, R24.2, R26.2, R27.2, R35.2, TP17.1, U5.11 (TEST), U5.37 (VSS), U20.1 (A0), U20.2 (A1), U20.3 (A2), U20.4 (GND), U20.7 (WP), U22.2 (GND), X1.2 (G), X1.4 (G); also elsewhere on the board
HUB_MR_N: C37.1, R33.2, TP14.1, U5.26 (RESET_N); also elsewhere on the board
HUB_SCL: R28.2, TP16.1, U5.24 (SCL/SMBCLK/CFG_SEL0), U20.6 (SCL); also elsewhere on the board
HUB_SDA: R30.2, TP15.1, U5.22 (SDA/SMBDATA/NON_REM1), U20.5 (SDA); also elsewhere on the board
USB_DN1_DM: U5.2 (USBDP_DN1/PRT_DIS_P1); also elsewhere on the board
USB_DN1_DP: U5.1 (USBDM_DN1/PRT_DIS_M1); also elsewhere on the board
USB_DN2_DM: U5.4 (USBDP_DN2/PRT_DIS_P2); also elsewhere on the board
USB_DN2_DP: U5.3 (USBDM_DN2/PRT_DIS_M2); also elsewhere on the board
USB_DN3_DM: U5.7 (USBDP_DN3/PRT_DIS_P3); also elsewhere on the board
USB_DN3_DP: U5.6 (USBDM_DN3/PRT_DIS_M3); also elsewhere on the board
USB_DN4_DM: U5.9 (USBDP_DN4/PRT_DIS_P4); also elsewhere on the board
USB_DN4_DP: U5.8 (USBDM_DN4/PRT_DIS_M4); also elsewhere on the board

Notes on the sheet:
USB2514BI HUB, I2C-EEPROM config mode: CFG_SEL[1:0] = 11 (pull-ups on pins 24, 25). Straps are ignored in this mode - the 24LC02B carries: all 4 ports non-removable, OC sensing unused, self-powered, VID/PID 0424/2514, serial number set. TEST to GND. No port power switches. PORT SWAP: downstream D+/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
TEST POINTS - hub
HUB BRING-UP HEADER (Rev B): 1 = +3.3V, 2 = +3V3_HUB, 3 = GND. Jumper 1-2 = normal. With the hub unpowered the MCU must keep HUB_SDA/SCL/MR_N tri-stated (no back-powering).
USB-C UPSTREAM. PRTR5V0U2F routed THROUGH (pins 1/6 one channel, 3/4 the other) - no stub. Chosen over USBLC6 for its GND-VCC diode: protected with no host / no VBUS present. CC1/CC2 terminate in 5.1k Rd only. A6/B6 and A7/B7 tied for either orientation.
Hub config EEPROM - private bus. Never on the inter-board harness: three 24LC02Bs at 0xA0 and three hub masters would collide.

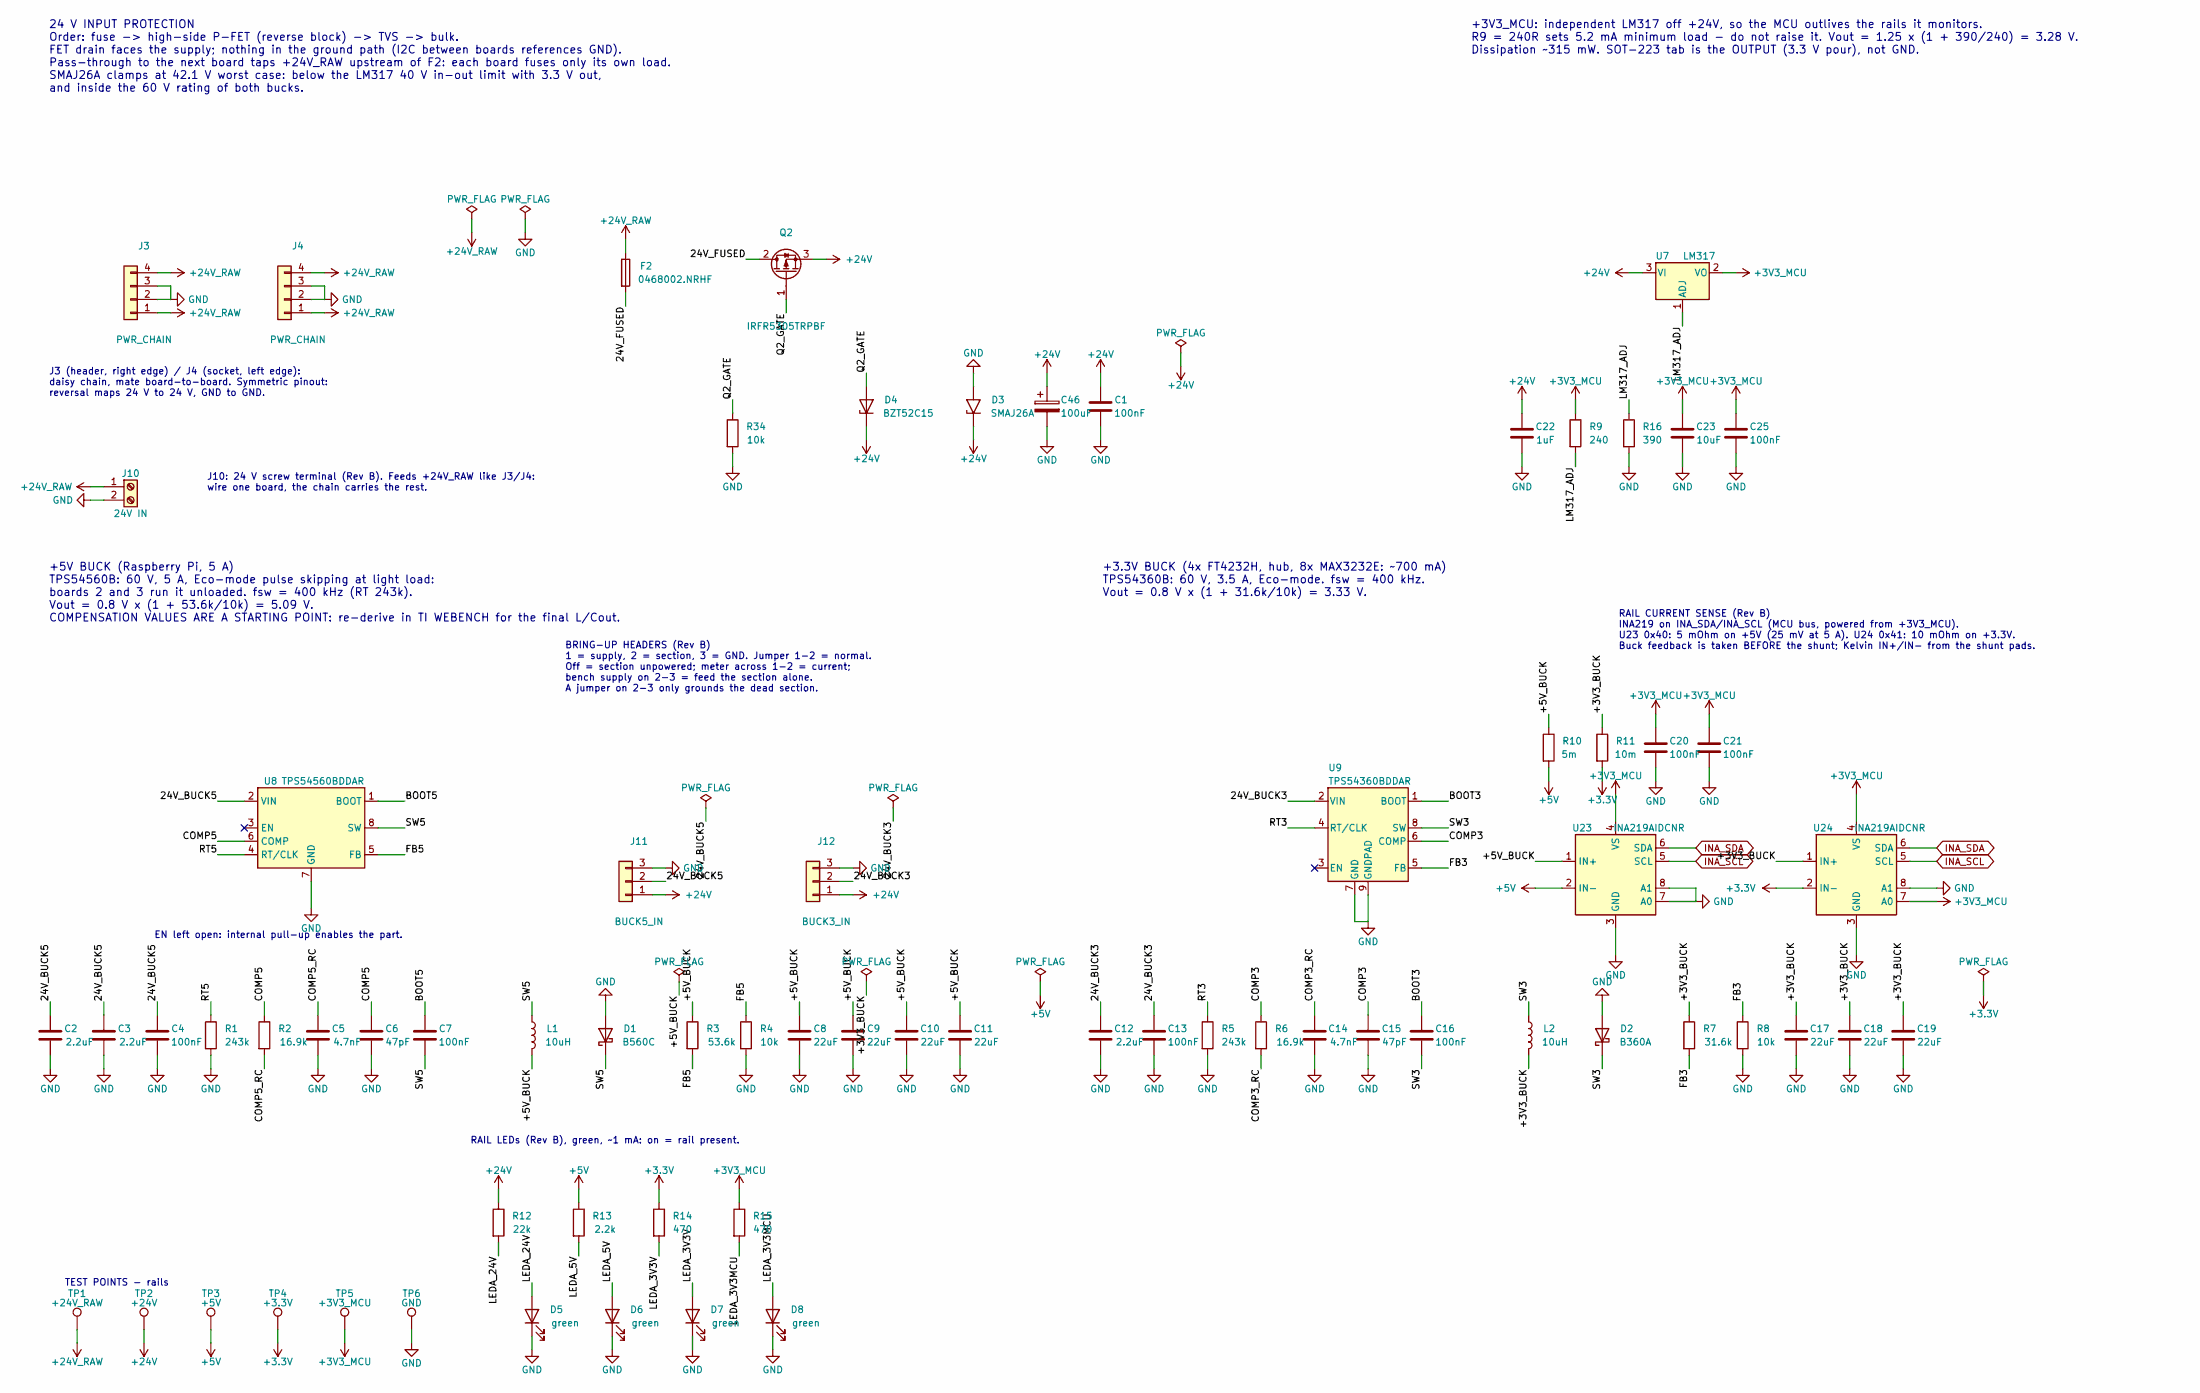
[picture p8: schematic power.kicad_sch, Power: 24 V input, rails]

Parts:
C1, C4, C7, C13, C16, C20, C21, C25: 100nF; C_0603_1608Metric; LCSC C14663
C2, C3, C12: 2.2uF; C_1210_3225Metric; LCSC C153036
C5, C14: 4.7nF; C_0603_1608Metric; LCSC C53987
C6, C15: 47pF; C_0603_1608Metric; LCSC C1671
C8, C9, C10, C11, C17, C18, C19: 22uF; C_1206_3216Metric; LCSC C77091
C22: 1uF; C_0805_2012Metric; LCSC C91185
C23: 10uF; C_0805_2012Metric; LCSC C15850
C46: 100uF; CP_Elec_10x10.5; LCSC C51953411
D1: B560C; D_SMC; LCSC C85100
D2: B360A; D_SMA; LCSC C94193
D3: SMAJ26A; D_SMA; LCSC C148225
D4: BZT52C15; D_SOD-123; LCSC C668893
D5, D6, D7, D8: green; LED_0603_1608Metric; LCSC C965805
F2: 0468002.NRHF; Fuse_1206_3216Metric; LCSC C187611
J3: PWR_CHAIN; PinHeader_1x04_P2.54mm_Horizontal; LCSC C492412
J4: PWR_CHAIN; PinSocket_1x04_P2.54mm_Horizontal; LCSC C2897386
J10: 24V IN; TerminalBlock_Phoenix_MKDS-1,5-2-5.08_1x02_P5.08mm_Horizont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; LCSC C8465
J11: BUCK5_IN; PinHeader_1x03_P2.54mm_Vertical; LCSC C49257
J12: BUCK3_IN; PinHeader_1x03_P2.54mm_Vertical; LCSC C49257
L1: 10uH; L_Bourns_SRP1265A; MPN TMPC1265HP-100MG-D; LCSC C305223
L2: 10uH; L_Bourns_SRP7028A_7.3x6.6mm; MPN SRP7028A-100M; LCSC C2687402
Q2: IRFR5305TRPBF; TO-252-3_L6.5-W6.1-P4.58-LS9.9-BR; LCSC C2624
R1, R5: 243k; R_0603_1608Metric; LCSC C403098
R2, R6: 16.9k; R_0603_1608Metric; LCSC C2933158
R3: 53.6k; R_0603_1608Metric; LCSC C2930115
R4, R8, R34: 10k; R_0603_1608Metric; LCSC C25804
R7: 31.6k; R_0603_1608Metric; LCSC C25967
R9: 240; R_0603_1608Metric; LCSC C114613
R10: 5m; R_2512_6332Metric; LCSC C393074
R11: 10m; R_1206_3216Metric; LCSC C188070
R12: 22k; R_0603_1608Metric; LCSC C31850
R13: 2.2k; R_0603_1608Metric; LCSC C4190
R14, R15: 470; R_0603_1608Metric; LCSC C23179
R16: 390; R_0603_1608Metric; LCSC C23151
TP1: +24V_RAW; TestPoint_Pad_D1.5mm
TP2: +24V; TestPoint_Pad_D1.5mm
TP3: +5V; TestPoint_Pad_D1.5mm
TP4: +3.3V; TestPoint_Pad_D1.5mm
TP5: +3V3_MCU; TestPoint_Pad_D1.5mm
TP6: GND; TestPoint_Pad_D1.5mm
U7: LM317; SOT-223-3_TabPin2; LCSC C5296732
U8: TPS54560BDDAR; Texas_HSOP-8-1EP_3.9x4.9mm_P1.27mm_ThermalVias; LCSC C1850354
U9: TPS54360BDDAR; TI_SO-PowerPAD-8_ThermalVias; LCSC C524806
U23, U24: INA219AIDCNR; SOT-23-8; LCSC C87469

Connections:
+3.3V: R11.2, R14.1, TP4.1, U24.2 (IN-); also elsewhere on the board
+3V3_MCU: C20.1, C21.1, C23.1, C25.1, R9.1, R15.1, TP5.1, U7.2 (VO), U23.4 (VS), U24.4 (VS), U24.7 (A0); also elsewhere on the board
+5V: R10.2, R13.1, TP3.1, U23.2 (IN-); also elsewhere on the board
+24V: C1.1, C22.1, C46.1, D3.1 (A1), D4.1 (K), J11.1, J12.1, Q2.3 (S), R12.1, TP2.1, U7.3 (VI); also elsewhere on the board
+24V_RAW: F2.1, J3.1, J3.4, J4.1, J4.4, J10.1, TP1.1
/Power/24V_BUCK3: C12.1, C13.1, J12.2, U9.2 (VIN)
/Power/24V_BUCK5: C2.1, C3.1, C4.1, J11.2, U8.2 (VIN)
/Power/24V_FUSED: F2.2, Q2.2 (D)
/Power/+3V3_BUCK: C17.1, C18.1, C19.1, L2.2, R7.1, R11.1, U24.1 (IN+)
/Power/+5V_BUCK: C8.1, C9.1, C10.1, C11.1, L1.2, R3.1, R10.1, U23.1 (IN+)
/Power/BOOT3: C16.1, U9.1 (BOOT)
/Power/BOOT5: C7.1, U8.1 (BOOT)
/Power/COMP3: C15.1, R6.1, U9.6 (COMP)
/Power/COMP3_RC: C14.1, R6.2
/Power/COMP5: C6.1, R2.1, U8.6 (COMP)
/Power/COMP5_RC: C5.1, R2.2
/Power/FB3: R7.2, R8.1, U9.5 (FB)
/Power/FB5: R3.2, R4.1, U8.5 (FB)
/Power/LEDA_3V3MCU: D8.2 (A), R15.2
/Power/LEDA_3V3V: D7.2 (A), R14.2
/Power/LEDA_5V: D6.2 (A), R13.2
/Power/LEDA_24V: D5.2 (A), R12.2
/Power/LM317_ADJ: R9.2, R16.1, U7.1 (ADJ)
/Power/Q2_GATE: D4.2 (A), Q2.1 (G), R34.1
/Power/RT3: R5.1, U9.4 (RT/CLK)
/Power/RT5: R1.1, U8.4 (RT/CLK)
/Power/SW3: C16.2, D2.1 (K), L2.1, U9.8 (SW)
/Power/SW5: C7.2, D1.1 (K), L1.1, U8.8 (SW)
GND: C1.2, C2.2, C3.2, C4.2, C5.2, C6.2, C8.2, C9.2, C10.2, C11.2, C12.2, C13.2, C14.2, C15.2, C17.2, C18.2, C19.2, C20.2, C21.2, C22.2, C23.2, C25.2, C46.2, D1.2 (A), D2.2 (A), D3.2 (A2), D5.1 (K), D6.1 (K), D7.1 (K), D8.1 (K), J3.2, J3.3, J4.2, J4.3, J10.2, J11.3, J12.3, R1.2, R4.2, R5.2, R8.2, R16.2, R34.2, TP6.1, U8.7 (GND), U8.9 (GND), U9.7 (GND), U9.9 (GNDPAD), U23.3 (GND), U23.7 (A0), U23.8 (A1), U24.3 (GND), U24.8 (A1); also elsewhere on the board
INA_SCL: U23.5 (SCL), U24.5 (SCL); also elsewhere on the board
INA_SDA: U23.6 (SDA), U24.6 (SDA); also elsewhere on the board

Notes on the sheet:
TEST POINTS - rails
RAIL LEDs (Rev B), green, ~1 mA: on = rail present.
24 V INPUT PROTECTION Order: fuse -> high-side P-FET (reverse block) -> TVS -> bulk. FET drain faces the supply; nothing in the ground path (I2C between boards references GND). Pass-through to the next board taps +24V_RAW upstream of F2: each board fuses only its own load. SMAJ26A clamps at 42.1 V 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
EN left open: internal pull-up enables the part.
J10: 24 V screw terminal (Rev B). Feeds +24V_RAW like J3/J4: wire one board, the chain carries the rest.
RAIL CURRENT SENSE (Rev B) INA219 on INA_SDA/INA_SCL (MCU bus, powered from +3V3_MCU). U23 0x40: 5 mOhm on +5V (25 mV at 5 A). U24 0x41: 10 mOhm on +3.3V. Buck feedback is taken BEFORE the shunt; Kelvin IN+/IN- from the shunt pads.
J3 (header, right edge) / J4 (socket, left edge): daisy chain, mate board-to-board. Symmetric pinout: reversal maps 24 V to 24 V, GND to GND.
BRING-UP HEADERS (Rev B) 1 = supply, 2 = section, 3 = GND. Jumper 1-2 = normal. Off = section unpowered; meter across 1-2 = current; bench supply on 2-3 = feed the section alone. A jumper on 2-3 only grounds the dead section.
+3.3V BUCK (4x FT4232H, hub, 8x MAX3232E: ~700 mA) TPS54360B: 60 V, 3.5 A, Eco-mode. fsw = 400 kHz. Vout = 0.8 V x (1 + 31.6k/10k) = 3.33 V.
+3V3_MCU: independent LM317 off +24V, so the MCU outlives the rails it monitors. R9 = 240R sets 5.2 mA minimum load - do not raise it. Vout = 1.25 x (1 + 390/240) = 3.28 V. Dissipation ~315 mW. SOT-223 tab is the OUTPUT (3.3 V pour), not GND.
+5V BUCK (Raspberry Pi, 5 A) TPS54560B: 60 V, 5 A, Eco-mode pulse skipping at light load: boards 2 and 3 run it unloaded. fsw = 400 kHz (RT 243k). Vout = 0.8 V x (1 + 53.6k/10k) = 5.09 V. COMPENSATION VALUES ARE A STARTING POINT: re-derive in TI WEBENCH for the final L/Cout.

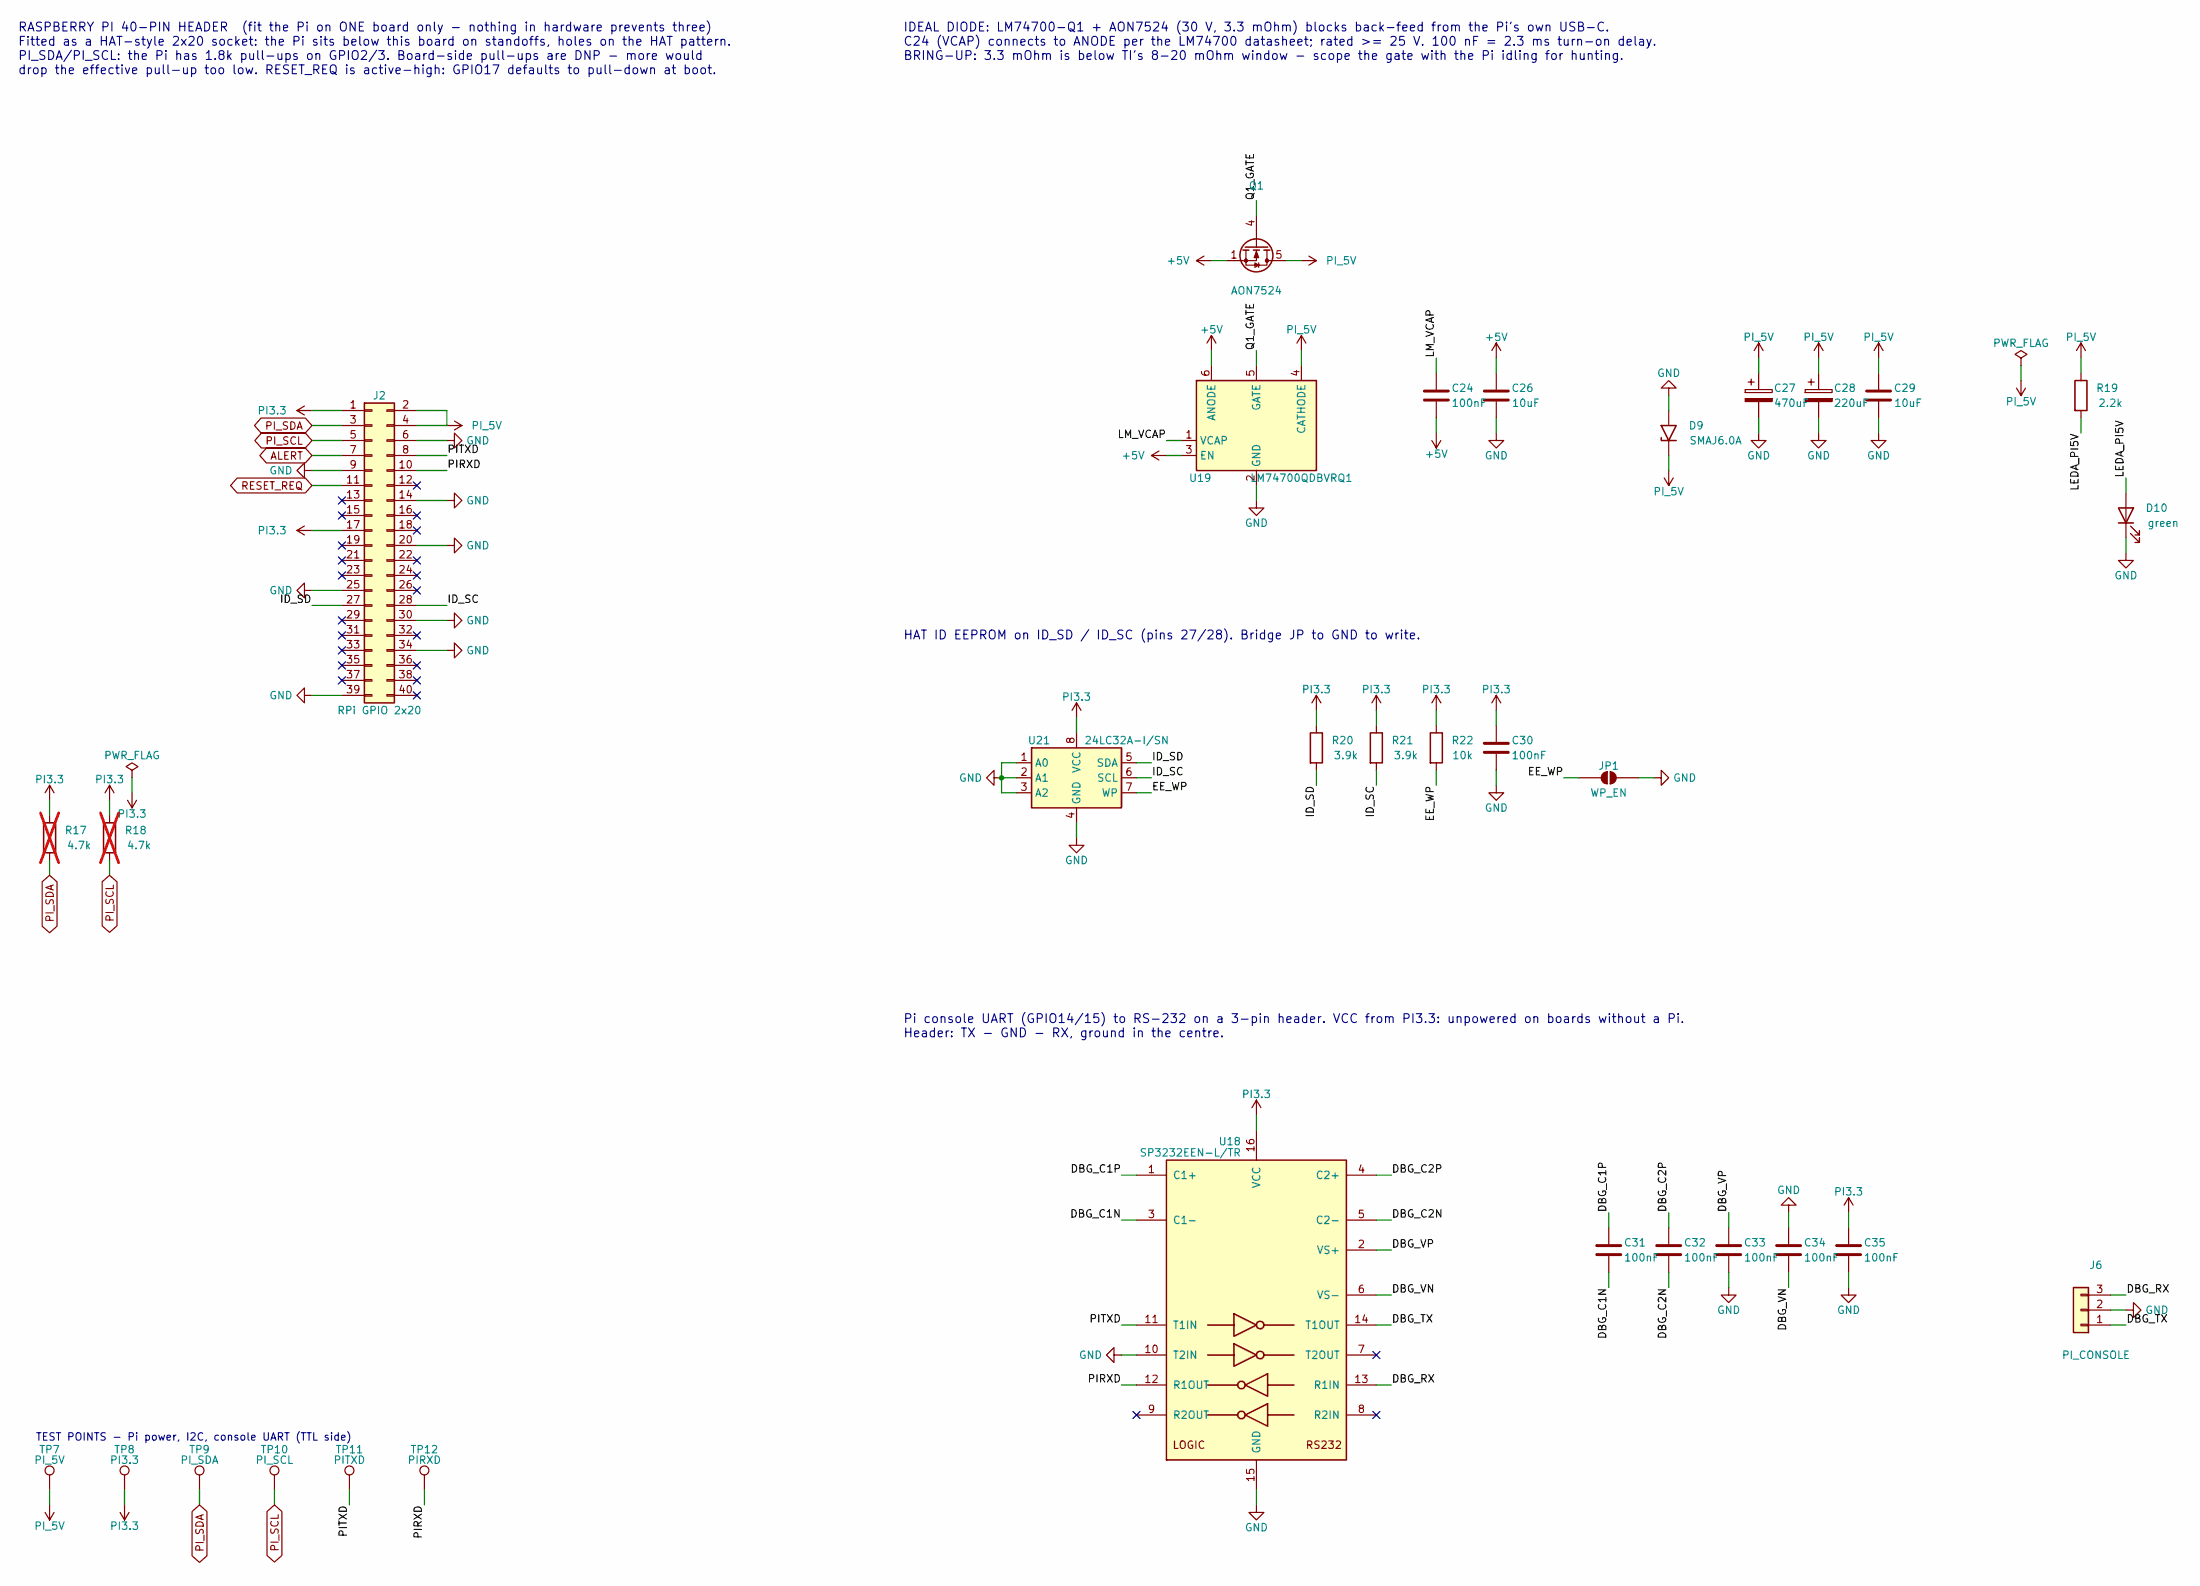
[picture p9: schematic pi.kicad_sch, Raspberry Pi interface]

Parts:
C24, C30, C31, C32, C33, C34, C35: 100nF; C_0603_1608Metric; LCSC C14663
C26, C29: 10uF; C_0805_2012Metric; LCSC C15850
C27: 470uF; CP_Elec_6.3x7.7; LCSC C335982
C28: 220uF; CP_Elec_6.3x5.4; LCSC C72494
D9: SMAJ6.0A; D_SMA; LCSC C223993
D10: green; LED_0603_1608Metric; LCSC C965805
J2: RPi GPIO 2x20; PinSocket_2x20_P2.54mm_Vertical; LCSC C2977589
J6: PI_CONSOLE; PinHeader_1x03_P2.54mm_Vertical; LCSC C49257
JP1: WP_EN; SolderJumper-2_P1.3mm_Open_RoundedPad1.0x1.5mm
Q1: AON7524; DFN-8_L3.0-W3.0-P0.65-BL-2; LCSC C431195
R17, R18: 4.7k; R_0603_1608Metric; LCSC C23162; not fitted
R19: 2.2k; R_0603_1608Metric; LCSC C4190
R20, R21: 3.9k; R_0603_1608Metric; LCSC C23018
R22: 10k; R_0603_1608Metric; LCSC C25804
TP7: PI_5V; TestPoint_Pad_D1.5mm
TP8: PI3.3; TestPoint_Pad_D1.5mm
TP9: PI_SDA; TestPoint_Pad_D1.0mm
TP10: PI_SCL; TestPoint_Pad_D1.0mm
TP11: PITXD; TestPoint_Pad_D1.0mm
TP12: PIRXD; TestPoint_Pad_D1.0mm
U18: SP3232EEN-L/TR; SOIC-16_3.9x9.9mm_P1.27mm; LCSC C9378
U19: LM74700QDBVRQ1; SOT-23-6; LCSC C2941042
U21: 24LC32A-I/SN; SOIC-8_3.9x4.9mm_P1.27mm; LCSC C511262

Connections:
+5V: C24.2, C26.1, Q1.1 (S), Q1.2 (S), Q1.3 (S), U19.3 (EN), U19.6 (ANODE); also elsewhere on the board
/Pi/DBG_C1N: C31.2, U18.3 (C1-)
/Pi/DBG_C1P: C31.1, U18.1 (C1+)
/Pi/DBG_C2N: C32.2, U18.5 (C2-)
/Pi/DBG_C2P: C32.1, U18.4 (C2+)
/Pi/DBG_RX: J6.3, U18.13 (R1IN)
/Pi/DBG_TX: J6.1, U18.14 (T1OUT)
/Pi/DBG_VN: C34.2, U18.6 (VS-)
/Pi/DBG_VP: C33.1, U18.2 (VS+)
/Pi/EE_WP: JP1.1 (A), R22.2, U21.7 (WP)
/Pi/ID_SC: J2.28, R21.2, U21.6 (SCL)
/Pi/ID_SD: J2.27, R20.2, U21.5 (SDA)
/Pi/LEDA_PI5V: D10.2 (A), R19.2
/Pi/LM_VCAP: C24.1, U19.1 (VCAP)
/Pi/PIRXD: J2.10, TP12.1, U18.12 (R1OUT)
/Pi/PITXD: J2.8, TP11.1, U18.11 (T1IN)
/Pi/Q1_GATE: Q1.4 (G), U19.5 (GATE)
ALERT: J2.7; also elsewhere on the board
GND: C26.2, C27.2, C28.2, C29.2, C30.2, C33.2, C34.1, C35.2, D9.2 (A2), D10.1 (K), J2.6, J2.9, J2.14, J2.20, J2.25, J2.30, J2.34, J2.39, J6.2, JP1.2 (B), U18.10 (T2IN), U18.15 (GND), U19.2 (GND), U21.1 (A0), U21.2 (A1), U21.3 (A2), U21.4 (GND); also elsewhere on the board
PI3.3: C30.1, C35.1, J2.1, J2.17, R17.1, R18.1, R20.1, R21.1, R22.1, TP8.1, U18.16 (VCC), U21.8 (VCC); also elsewhere on the board
PI_5V: C27.1, C28.1, C29.1, D9.1 (A1), J2.2, J2.4, Q1.5 (D), Q1.6 (D), Q1.7 (D), Q1.8 (D), Q1.9 (D), R19.1, TP7.1, U19.4 (CATHODE)
PI_SCL: J2.5, R18.2, TP10.1; also elsewhere on the board
PI_SDA: J2.3, R17.2, TP9.1; also elsewhere on the board
RESET_REQ: J2.11; also elsewhere on the board

Notes on the sheet:
Pi console UART (GPIO14/15) to RS-232 on a 3-pin header. VCC from PI3.3: unpowered on boards without a Pi. Header: TX - GND - RX, ground in the centre.
IDEAL DIODE: LM74700-Q1 + AON7524 (30 V, 3.3 mOhm) blocks back-feed from the Pi's own USB-C. C24 (VCAP) connects to ANODE per the LM74700 datasheet; rated >= 25 V. 100 nF = 2.3 ms turn-on delay. BRING-UP: 3.3 mOhm is below TI's 8-20 mOhm window - scope the gate with the Pi idling for hunting.
RASPBERRY PI 40-PIN HEADER (fit the Pi on ONE board only - nothing in hardware prevents three) Fitted as a HAT-style 2x20 socket: the Pi sits below this board on standoffs, holes on the HAT pattern. PI_SDA/PI_SCL: the Pi has 1.8k pull-ups on GPIO2/3. Board-side pull-ups are DNP - more would drop th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
TEST POINTS - Pi power, I2C, console UART (TTL side)
HAT ID EEPROM on ID_SD / ID_SC (pins 27/28). Bridge JP to GND to write.
