TheKingOfChaos/Console-Server/usb-console-server.kicad_pcb

## KiCad design usb-console-server.kicad_pcb (continued)

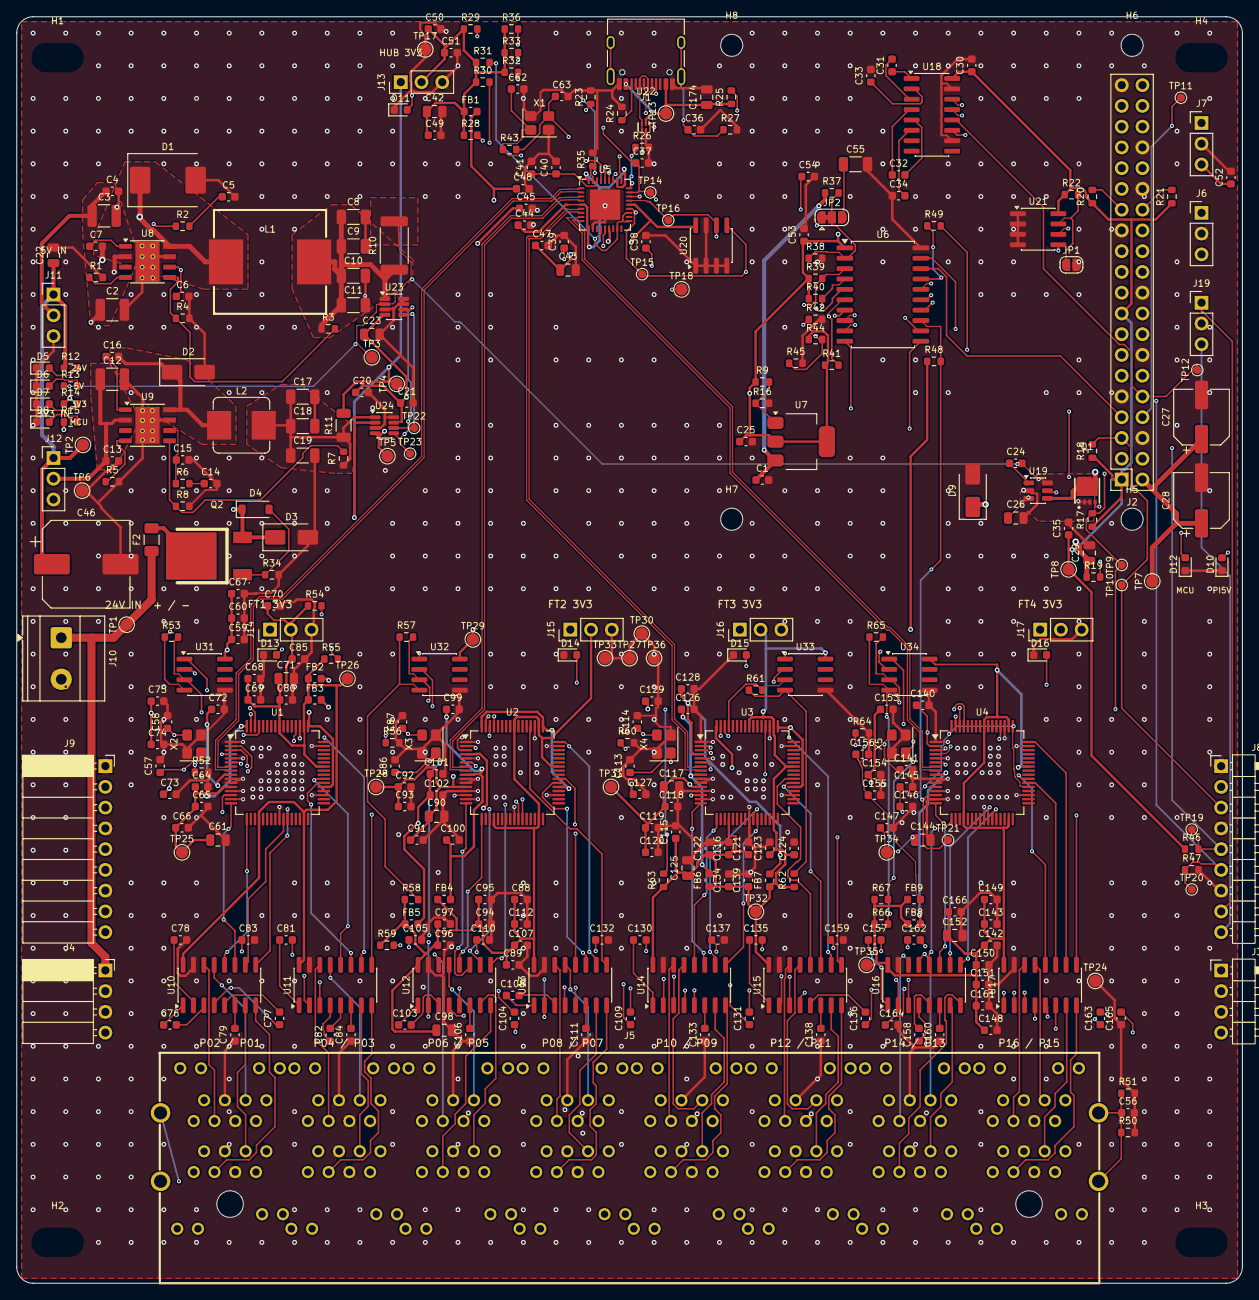
[picture p10: board usb-console-server.kicad_pcb from above]

Board: 4 copper layers, 150.0 x 155.0 mm, 361 parts (0 on the bottom side), 255 nets.
