TheKingOfChaos/Console-Server/tools/sexp.py

"""Minimal S-expression reader/writer for KiCad files."""
import re

class Sym(str):
    """Bare (unquoted) atom."""

_tok = re.compile(r'\s*(?:(\()|(\))|"((?:[^"\\]|\\.)*)"|([^\s()"]+))', re.S)

def parse(text):
    stack, cur = [], []
    pos = 0
    n = len(text)
    while pos < n:
        m = _tok.match(text, pos)
        if not m:
            if text[pos:].strip() == '':
                break
            raise ValueError(f'bad token at {pos}: {text[pos:pos+40]!r}')
        pos = m.end()
        o, c, q, a = m.groups()
        if o:
            stack.append(cur); cur = []
        elif c:
            done = cur; cur = stack.pop(); cur.append(done)
        elif q is not None:
            cur.append(q.replace('\\"', '"').replace('\\\\', '\\'))
        elif a is not None:
            cur.append(Sym(a))
    return cur[0] if len(cur) == 1 else cur

def q(s):
    s = str(s).replace('\\', '\\\\').replace('"', '\\"').replace('\n', '\\n')
    return '"' + s + '"'

def dump(x, ind=0):
    if isinstance(x, list):
        if not x:
            return '()'
        simple = all(not isinstance(e, list) for e in x)
        if simple:
            return '(' + ' '.join(dump(e) for e in x) + ')'
        out = '(' + dump(x[0])
        for e in x[1:]:
            if isinstance(e, list):
                out += '\n' + '\t' * (ind + 1) + dump(e, ind + 1)
            else:
                out += ' ' + dump(e)
        return out + '\n' + '\t' * ind + ')'
    if isinstance(x, Sym):
        return str(x)
    if isinstance(x, bool):
        return 'yes' if x else 'no'
    if isinstance(x, (int, float)):
        return fmt(x)
    return q(x)

def fmt(v):
    if isinstance(v, int):
        return str(v)
    s = f'{v:.4f}'.rstrip('0').rstrip('.')
    return '0' if s in ('-0', '') else s

def find(node, key):
    return [e for e in node if isinstance(e, list) and e and e[0] == key]

def first(node, key):
    r = find(node, key)
    return r[0] if r else None
