TheKingOfChaos/Console-Server/(commit log)

2026-10-11 USB console server: 48-port RS-232 console server for a Raspberry Pi
    KiCad 10 project: generated schematic (7 sheets), 4-layer 138x141 mm board,
    fully routed with coupled, length-matched hub-to-FT4232H USB pairs.
    DRC: 0 errors, 0 unconnected, schematic parity clean. Includes the
    generator/routing tools and a JLCPCB order package (gerbers, BOM, CPL).
    [ftdi.kicad_sch, hub.kicad_sch, mcu.kicad_sch, pi.kicad_sch, ports.kicad_sch, power.kicad_sch, usb-console-server.kicad_pcb, usb-console-server.kicad_sch]
2026-10-11 Add complete 3D model and STEP export
    - J5 (16-port RJ45 block): simplified envelope model from tools/rj45_model.py
    (no vendor model exists; height 25.4 mm assumed)
    - L2 and J1 (USB-C): EasyEDA models; U8/U9: renamed KiCad 10 stock models
    (tools/fix_3d_models.py)
    - 3d/usb-console-server.step: whole board with all parts, plus a preview render
    [usb-console-server.kicad_pcb, usb-console-server.step]
2026-10-18 Add LCSC order lists; give J6/J7 headers an LCSC number
    - tools/lcsc_order.py: LCSC BOM Tool upload lists for N boards (all parts, and
    through-hole-only for when JLCPCB assembles the SMD side)
    - J6/J7 1x3 2.54 mm headers: C49257
    [mcu.kicad_sch, pi.kicad_sch, usb-console-server_bom.csv, usb-console-server_hand_solder.csv, usb-console-server_lcsc_order_3boards.csv, usb-console-server_lcsc_order_3boards_through_hole_only.csv]
2026-10-19 Replace parts LCSC has on backorder with in-stock equivalents
    47k C111134, 1k C22548, 240R C114613, 243k C403098, 1uF C91185, 22uF C77091,
    LM74700QDBVTQ1 C2653623, TMPC1265HP-100MG-D C305223 (L1), AON7524 C431195 (Q1).
    Same values, packages and land patterns. The JLCPCB assembly BOM keeps the four
    JLC Basic originals that JLCPCB itself still stocks.
    [hub.kicad_sch, mcu.kicad_sch, pi.kicad_sch, power.kicad_sch, usb-console-server.kicad_pcb, usb-console-server_bom.csv, usb-console-server_bom_jlc.csv, usb-console-server_lcsc_order_3boards.csv]
2026-10-19 Use in-stock 24 MHz crystal (C5444545) and green LED (C12065); add 5-board LCSC list
    Both originals (C70590, C72043) are out of stock at LCSC; the replacements have the
    same spec and package. Adds usb-console-server_lcsc_order_5boards.csv and a small
    add-missing list for the cart.
    [hub.kicad_sch, mcu.kicad_sch, usb-console-server.kicad_pcb, usb-console-server_bom.csv, usb-console-server_bom_jlc.csv, usb-console-server_lcsc_add_missing_5boards.csv, usb-console-server_lcsc_order_3boards.csv, usb-console-server_lcsc_order_5boards.csv]
2026-10-31 Rev B schematic: bring-up headers, rail LEDs, INA219 current sense, 24 V terminal
    - 3-pin bring-up header (supply - section - GND) in front of the 5 V buck,
    3.3 V buck, hub and each FT4232H cluster; green power LED on every rail and section
    - INA219 + shunt on +5V (5 mOhm) and +3.3V (10 mOhm), on a private MCU I2C bus
    (PA5/PA6, replaces the 5 V / 3.3 V ADC dividers)
    - J10: 5.08 mm 2-pin screw terminal on +24V_RAW
    - J19: MCU UART header (USART0 on PB2/PB3)
    [ftdi.kicad_sch, hub.kicad_sch, mcu.kicad_sch, pi.kicad_sch, ports.kicad_sch, power.kicad_sch, usb-console-server.kicad_sch]
2026-10-31 Rev B board: 150x155 mm floor plan, hand-placed buck stages, bring-up headers
    Hub moved to the top middle so the four USB pairs fall straight down a free
    corridor to the clusters (all four now route on F.Cu, no vias); power in the
    top-left corner with each buck's inductor, diode, output caps, shunt and INA219
    placed by hand; 24 V terminal and protection on the left edge.
2026-10-31 Rev B: routed and DRC clean, exports, 3D model, README
    150 x 155 mm, 0 DRC errors, 0 unconnected, schematic parity clean. All four
    hub-to-FT4232H USB pairs on F.Cu, coupled, 1.1-1.9 mm skew, no vias.
    Hand fixes after the generated routing: FT1 VPHY escape via (VCORE B.Cu track
    moved), TP12 nudged, one GND via in an isolated F.Cu island.
    JLCPCB/LCSC exports updated (bring-up headers, terminal and jumper caps on the
    hand-solder list), STEP model with every part, README Rev B section and
    bring-up checklist.
    [ftdi.kicad_sch, hub.kicad_sch, mcu.kicad_sch, pi.kicad_sch, ports.kicad_sch, power.kicad_sch, usb-console-server.kicad_pcb, usb-console-server.kicad_sch]
2026-11-01 JLCPCB full-assembly option: through-hole parts fitted by JLCPCB too
    [usb-console-server_full_bom_jlc.csv, usb-console-server_full_loose_parts.csv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]
2026-11-04 Replace 3 parts JLCPCB can't supply for 5 boards
    - green LEDs C12065 (7 in stock) -> C965805 yellow-green 0603 (Vf ~2.2 V, better on 3.3 V)
    - U6 ATtiny3216-SNR C609661 (1 in stock) -> ATtiny3216-SF C1340355 (same chip, -40..125 C)
    - U19 LM74700QDBVTQ1 C2653623 (2 in stock) -> LM74700QDBVRQ1 C2941042 (same chip, full reel)
    [ftdi.kicad_sch, hub.kicad_sch, mcu.kicad_sch, pi.kicad_sch, power.kicad_sch, usb-console-server.kicad_pcb, usb-console-server_bom.csv, usb-console-server_bom_jlc.csv]
